Mang0-TEC/esp32-photo-frame/docs/BOM-marco-fotos-esp32.md

# BOM — Marco de Fotos Digital ESP32

**Proyecto:** Marco de fotos digital con servidor local WiFi
**Presupuesto objetivo:** $700 MXN
**Gastado:** $514 MXN · **Pendiente de comprar:** $0

---

## A. Comprar

**Nada. La tabla está vacía por primera vez en el proyecto.**

Lo último que quedaba era la reposición del sensor de luz, y **no se repuso: se
sustituyó**. El GY-302 (BH1750) que se estropeó en el banco el 7-ago-2026 se
cambió por un **módulo TSL2561 de Handson Technology**, SKU `SSR1026`, **$127** —
ya comprado y en mano. Con eso el gastado sube de $387 a **$514** y el pendiente
baja a cero, contra un presupuesto objetivo de $700.

**No es un reemplazo pin a pin, y por eso tiene sección propia más abajo.** El
módulo lleva regulador de 3.3 V a bordo, así que su alimentación cambia de riel;
`ADDR` deja de ser un cable y pasa a ser un puente soldable en la placa; aparece
un `INT` que no se usa; y el chip entrega **dos canales crudos** en vez de un
registro de lux ya calculado. El `0x23` medido del BH1750 no se transfiere.

**El ESP32 de reposición** estuvo en esta tabla porque la unidad USB-C que había
resultó defectuosa — no transmitía ni sincronizaba con esptool, ni en macOS ni en
Windows, pese a 3.3 V correctos, `EN` liberado y loopback TX0↔RX0 exitoso. Ese
diagnóstico sigue cerrado: la unidad nueva es **otra placa física**, con puente y
revisión de silicio distintos, no la misma que volvió a probarse.

**Debe ser WROOM, no WROVER.** La WROVER ocupa GPIO16 y GPIO17 con la PSRAM, y
ahí van `RST` y `DC` del display. **Confirmado WROOM en la unidad nueva**, medido
—no leído de la etiqueta— con `ESP.getPsramSize()` desde el banco del LED:
`PSRAM 0 B`. GPIO16 y GPIO17 quedan libres y el mapa de pines cierra. esptool no
reporta PSRAM, de ahí que la comprobación viva en el banco; sale gratis porque ese
flasheo se hace igual, y descubrirlo después de soldar cuesta la pantalla entera.

---

## B. Ya en inventario

| # | Componente | Nota |
|---|---|---|
| 5 | ESP32 DevKit WROOM, **micro-USB** | **Placa de desarrollo.** Puente CP2102, `/dev/cu.usbserial-0001`. Chip verificado `ESP32-D0WD-V3 rev v3.0`, cristal 40 MHz, flash 4 MB |
| 6 | Tarjeta SD 8 GB | FAT32, fotos en subdirectorio `/fotos/` |
| 7 | Cargador USB 5 V ≥1 A + cable USB-C | Alimentación permanente |
| 8 | Capacitor electrolítico 100 µF / 16 V | ✔ Confirmado |
| 9 | Capacitores cerámicos 100 nF (código "104") | ✔ Confirmado — 3 piezas, de las que **solo se usan 2**: display y lector SD. El tercero quedó libre al entrar el TSL2561, que trae cuatro condensadores propios y uno de ellos pegado al `VDD` del chip |
| 10 | Transistor PN2222A (NPN, TO-92) | **Sin uso.** Era para el backlight en Caso A; `BL` resultó entrada lógica y va directo a GPIO19. Se queda en inventario |
| 11 | LED RGB 5 mm **cátodo común** | ✔ Sustituye a los dos LEDs separados |
| 12 | Resistencias **220 Ω** (LED rojo), 470 Ω ×2 (LED verde y azul), 10 kΩ, más surtido | El rojo llevaba 1 kΩ y **se cambió a 220 Ω** tras verse más apagado que los otros dos; con eso el blanco sale blanco. El 1 kΩ queda libre. Las dos 470 Ω están puestas en el LED, y **no hace falta una tercera**: el backlight resultó Caso B y va directo a GPIO19, sin transistor y sin resistencia de base. Ver la nota de corriente por canal, abajo |
| 13 | Header macho 2.54 mm (9 pines) | ✔ Confirmado |
| 14 | Cable UTP Cat5e (núcleo sólido 24 AWG) | ✔ Sustituye jumpers Dupont |
| 15 | Filamento **PETG negro** | Carcasa frontal, tapa trasera y base, ~70 g el juego completo — detalle en [`carcasa/README.md`](../carcasa/README.md). **Confirmado 10-oct-2026**, y no es PLA: el PLA reblandece cerca de 60 °C, y esto vive encendido 24/7, quizá junto a una ventana, dentro de una carcasa sellada donde el AMS1117 ya calienta. El PETG aguanta y es menos frágil. **El grosor de pared en la zona del pad NO es libre**: lo fija la medición del touch — ver la sección de touch capacitivo |
| 17 | Módulo **TSL2561** (Handson Technology, SKU `SSR1026`) — $127 ya pagados | **Sustituye al GY-302/BH1750**, que se estropeó en el banco. `Vin` va al riel de **5 V**, no a 3.3: lleva LDO propio (`662K`). Cinco pines, de los que se usan cuatro — `INT` se deja al aire. Dirección I2C **`0x39`, medida en placa**. Sección propia más abajo |
| 16 | ESP32 DevKit **USB-C** — reposición, $126 ya pagados | **Candidata a unidad final.** Puente **CH340** (`0x1a86:0x7523`). **Los `.ini` ya no fijan el puerto**: se quitaron `upload_port` y `monitor_port` de los cinco envs para que PlatformIO autodetecte, porque el sufijo del tty es el location ID del USB y cambia al mover el cable de puerto. Detalle del mecanismo en `CLAUDE.md`. Verificado con esptool: `ESP32-D0WD-V3 rev v3.1`, cristal 40 MHz, flash 4 MB, MAC `70:4b:ca:48:d3:ec`. **WROOM confirmado** — `PSRAM 0 B` medido desde el banco del LED |

La placa micro-USB **no es la unidad final**: micro-USB es mal conector para un
objeto fijo 24/7 durante años; se afloja y su pad termina desprendiéndose del
PCB. Sirve para todo el desarrollo del firmware — el chip es el mismo
`ESP32-D0WD-V3` — y el cambio a la USB-C final no toca una sola línea de código.

---

## C. Verificar / conseguir

| # | Componente | Cant. | Para qué |
|---|---|---|---|
| ~~16~~ | ~~Pad conductor para touch capacitivo~~ | 1 | **Resuelto: cinta de cobre** (opción 2), cuadrado de ~12-15 mm con un hilo de UTP a GPIO32. Cableado, trampas y montaje en la sección de touch capacitivo |
| 17 | Termofit surtido | — | Aislar uniones soldadas |
| 18 | Soldadura + flux | — | Header y cableado |
| 19 | Silicón caliente | — | Alivio de tensión del UTP |
| 20 | Tornillos M3×8 (Allen o avellanado) | 2 | Cierre de la carcasa. **Sin insertos termofijos** (no hay en inventario): roscan directo en dos postes de PETG, y la tapa además engancha un labio arriba. El diámetro del agujero se fija con la probeta de ajustes (2.5–2.8 mm) |

---

## D. Descartado (y por qué)

| Componente | Razón |
|---|---|
| ESP32-S3 DevKit | TJpg_Decoder trabaja por bloques MCU 16×16; no necesita framebuffer completo. El clásico basta |
| ESP32 **WROVER** | Ocupa GPIO16 y GPIO17 con la PSRAM, y ahí van `RST` y `DC` del display |
| Módulo USB standalone | El pin `5V`/`VIN` del devkit ya entrega VBUS |
| Step-down LM2596S | Solo haría falta alimentando desde 12 V |
| Batería LiPo | ~250 mA continuos → ~8 h. LCD necesita alimentación constante. Riesgo de hinchamiento en carcasa sellada |
| PIR HC-SR501 | Domo de 23 mm imposible de ocultar |
| Sensor ultrasónico HC-SR04 | Peor estética; cono de 15° detecta paredes, no personas |
| Sensor IR proximidad | Alcance de centímetros, no de habitación |
| Botón físico | Reemplazado por touch capacitivo del ESP32 (0 componentes) |
| Dos LEDs separados (verde + ámbar) | Reemplazados por el RGB: un solo barreno, más estados distinguibles |
| Jumpers Dupont | UTP soldado ocupa menos espacio interno |
| Google Drive como backend | OAuth2 se rompe solo con el tiempo; ata el regalo a una cuenta ajena |
| Switch de orientación / acelerómetro | Se decidió orientación nativa con barras. Reevaluar tras pruebas |
| Filamento PLA | Sustituido por PETG: el marco es un objeto cerrado y prendido 24/7, y el PLA se ablanda a temperatura más baja |
| Insertos roscados termofijos M3 | No hay en inventario. Los M3 roscan directo en postes de PETG, y solo hacen falta 2 |
| Pata trasera para sobremesa | Recargado hacia atrás, el marco se apoya en su canto trasero, y con el display al frente el centro de masa queda delante: vuelca a 15°. Se usa una base cuna |

---

## Mapa de GPIOs

| Función | Pin del módulo | GPIO |
|---|---|---|
| **Display — VSPI** | | |
| Reloj | `SCL` | 18 |
| Datos | `SDA` | 23 |
| Chip select | `CS` | 5 |
| Data/Command | `DC` | 17 |
| Reset | `RST` | 16 |
| Backlight (PWM) | `BL` | 19 |
| Salida de datos | `SDA-0` | **NC** |
| Alimentación | `VIN` / `GND` | **5 V** / GND |
| **Lector SD — HSPI** | | |
| Reloj | `SCK` | 14 |
| Datos hacia SD | `MOSI` | 13 |
| Datos desde SD | `MISO` | 27 |
| Chip select | `CS` | 26 |
| Alimentación | `+5` / `GND` | **5 V** / GND |
| **TSL2561 — I2C** (en orden físico del header) | | |
| Alimentación | `Vin` — pad cuadrado, pin 1 | **5 V** |
| Tierra | `GND` — pin 2 | GND |
| Reloj | `SCL` — pin 3 | 22 |
| Datos | `SDA` — pin 4 | 21 |
| Interrupción | `INT` — pin 5 | **NC** |
| **LED RGB (cátodo común)** | | |
| Azul (470 Ω) | pin 1 | 4 |
| Verde (470 Ω) | pin 2 | 33 |
| Común | pin 3 | GND |
| Rojo (220 Ω) | pin 4 | 25 |
| **Touch capacitivo** | | |
| Pad (T9) | — | 32 |

### Justificación de la asignación

- **GPIO12 evitado deliberadamente**, aunque es el MISO nativo del HSPI. Es pin de strapping: alto al arrancar configura la flash a 1.8 V y la placa no bootea. Como el H95 no trae buffer, MISO no queda en alta impedancia confiable → lotería en cada encendido. MISO va a GPIO27.
- **GPIO19 para backlight** aprovecha el pin liberado al no conectar `SDA-0`. Soporta PWM por LEDC.
- **GPIO0, 2 y 15 evitados** (strapping). **GPIO34-39 evitados** (solo entrada).
- **GPIO5 sí es strapping** pero necesita estar alto al arrancar — justo el estado de reposo de un CS.
- **Nota:** GPIOs 4, 13, 14, 25, 26, 27 son ADC2, que no funciona con WiFi activo. Aquí todos son digitales, sin problema. Tenerlo presente si se agrega un sensor analógico.

---

## Notas críticas de armado

### Alimentación

- **Display (`VIN`) y lector SD (`+5`) van al riel de 5 V**, no a 3.3 V. Ambos traen regulación propia. Así el AMS1117 del devkit no disipa el consumo del backlight (~0.7 W) dentro de una carcasa sellada sin ventilación.
- **En el lector SD, deja el pin `3.3V` sin conectar.** Solo se usa `+5`.
- **El TSL2561 va a 5 V, y esto CAMBIÓ respecto del BH1750.** El GY-302 iba a 3.3 V porque no llevaba regulador: el chip se alimentaba directo, y darle 5 V habría subido las líneas I2C por encima del nivel lógico del ESP32. Este módulo sí lo lleva —un `662K`, LDO de 3.3 V— así que entra en la misma regla que el display y el lector SD. **Las líneas I2C siguen a 3.3 V** porque las pull-ups cuelgan del riel *post-LDO*; en la sección del sensor está la medida que hay que hacer antes de conectarlo.
- **El capacitor de 100 µF no es opcional.** Entre 5 V y GND, lo más cerca posible del lector SD. Sin él, los picos de escritura hunden el riel y resetean el ESP32 — falla intermitente y difícil de diagnosticar con la carcasa cerrada.
- Un capacitor de 100 nF en VCC-GND de cada módulo: **display y lector SD**. Son dos de los tres cerámicos «104» de la tabla B; **el tercero quedó libre** al entrar el TSL2561, que trae los suyos.

> **El lector SD lleva LOS DOS, y no son redundantes** — es la duda que surge al leer las dos líneas de arriba seguidas. Cubren bandas de frecuencia distintas: el **electrolítico de 100 µF** es reserva de carga para las ráfagas de escritura (decenas de mA durante decenas de ms) y su ESR y ESL lo incapacitan para responder a un flanco de nanosegundos; el **cerámico de 100 nF** es desacoplo de alta frecuencia para los flancos del SPI y la lógica de la tarjeta, y no almacena nada útil a escala de milisegundos. Con solo el electrolítico el riel queda sucio en alta frecuencia; con solo el cerámico se hunde en cada escritura.
>
> **El cerámico va más cerca que el electrolítico**, lo más pegado posible a los pines `+5` y `GND` del módulo: el lazo corto es lo que lo hace funcionar. El electrolítico puede quedar un poco más atrás.
>
> **Y al sensor no le va NINGUNO de los dos, que es el caso opuesto y conviene leerlo aquí mismo.** El argumento de arriba es de corriente, y el TSL2561 consume **0.6 mA máximo y constante**: no hay ráfaga que amortiguar. Además el módulo ya trae cuatro condensadores propios —1 µF a la entrada del LDO, 10 µF y 0.1 µF a su salida, y **0.1 µF pegado al `VDD` del chip**—, así que el 100 nF que se iba a añadir habría quedado en paralelo con uno de 1 µF, diez veces mayor, y con un regulador de por medio. El trabajo de atender flancos junto al chip ya lo hace el suyo, que está más cerca de lo que jamás podría estar uno en el header.
>
> Eso salía del esquemático del módulo, que **ya falló en dos puntos verificables** contra la foto de su propia placa (dice 4.7 kΩ donde la foto muestra «103», y dibuja un puente de dos estados donde hay tres pads), así que quedó pendiente contar los condensadores de vista. **Se cierra el 8-ago-2026 por vía funcional, que es más fuerte que contarlos:** el módulo lee estable —1 % de dispersión en 10 muestras, y el mismo valor a lo largo de decenas de tandas— y **no produjo un solo error de I2C** salvo cuando se le desconectó el cable a propósito. Un desacoplo ausente se habría visto justo ahí. Si algún módulo de recambio diera lecturas ruidosas o errores de bus, el primer sospechoso es ése, y la salida es un 100 nF entre `Vin` y `GND` pegado al header.

### Backlight — determinar el tipo de pin `BL` antes de soldar

El pin `BL` equivale al `LED`/`BLK`/`LED-A` de otros módulos.

> **Corrección al procedimiento anterior, que era ambiguo.** La versión previa de
> esta tabla decía «solo uno funciona → respuesta inequívoca». **No es cierto:**
> dos desenlaces distintos mandan `BL` a alto y se ven idénticos en una prueba de
> sí/no, pero son circuitos muy diferentes —una entrada lógica pasa µA y un ánodo
> crudo pasa decenas de mA—. El discriminante es la **corriente**, no el
> encendido, y por eso el paso 3 lleva ahora una medición. Es la misma técnica que
> quedó escrita para el LED RGB: voltímetro sobre la resistencia e `I = V/R`.

#### Paso 0 — la lectura al aire, que es la que más dice y no cuesta nada

Solo `VIN` a 5 V y `GND`. `BL` **al aire**. Multímetro en DC volts de `BL` a GND: sus 10 MΩ de entrada pasan ~0.5 µA, así que no enciende ni daña nada.

| Lectura en `BL` al aire | Qué significa | Caso |
|---|---|---|
| ≈5 V (o ≈3.3 V) **y el backlight encendido** | entrada lógica con pull-up | **B** |
| ≈0 V, backlight apagado | entrada lógica con pull-down, o base flotante | **B** — confirmar en el paso 3 |
| **intermedia, ~1.5–3 V**, backlight apagado | hay un LED en serie hacia el riel: el nodo se queda un Vf por debajo | **A — cátodo crudo** |

La lectura intermedia es la firma de un diodo en el camino, y va antes de conectar ningún cable.

#### El paso decisivo: `BL` a un riel a través de 100 Ω, y medir la caída **sobre la resistencia**

Los 100 Ω hacen doble trabajo: limitan la corriente y sirven de shunt. `I = V/R`, la misma técnica que quedó escrita para el LED RGB. El entregable es la corriente, no el «prende sí o no».

### Resultado — pendiente #1 CERRADO, Caso B: `BL` es entrada lógica

**Medido en placa sobre el AR3952, con 100 Ω en serie:**

| Riel | V sobre los 100 Ω | Corriente | Tensión en `BL` |
|---|---|---|---|
| 5.0 V | 0.140 V | **1.40 mA** | 4.86 V |
| 3.3 V | 0.088 V | **0.88 mA** | 3.21 V |

Prende en los dos, y con un potenciómetro en serie la atenuación se distingue a simple vista.

**Por qué es inequívoco.** 1.40 mA no encienden un panel de 3.5". Si `BL` fuera el ánodo del string, la corriente del backlight —decenas de mA— pasaría por ese pin y el nodo quedaría clavado cerca del Vf, no a 0.14 V del riel. Que el panel encienda brillante mientras el pin pasa 1.4 mA significa que **la corriente del backlight sale de `VIN` por un driver del propio módulo**, y eso es la definición de una entrada de control.

**Y el Caso A queda descartado por la misma observación:** un cátodo crudo no puede encender con 5 V aplicados al pin — los LEDs quedarían sin tensión o en inversa.

**Las dos lecturas ajustan una recta y dan la impedancia de entrada:** ΔV/ΔI = (4.86 − 3.21) V / (1.40 − 0.88) mA = **3.17 kΩ**. Es un valor de catálogo para una resistencia de base, y explica la atenuación con el potenciómetro: control por corriente de base en zona activa. El ajuste deja un offset de ~0.42 V, más bajo que el Vbe de un BJT de silicio; con dos puntos de un multímetro de mano eso está en el ruido y **no se afirma si hay o no una unión ahí dentro**. Da igual para la decisión.

> **La tabla de umbrales que traía este documento se quedó corta y conviene decirlo.** Proponía «< 1 mA → entrada lógica» y «> 10 mA → ánodo», y el valor real, 1.4 mA, cayó en el hueco. El hueco no genera ambigüedad porque la pregunta de fondo es de orden de magnitud —¿es ésta la corriente del backlight o no?— y 1.4 mA está unas 70 veces por debajo de lo que consume el panel. El criterio correcto es ése, no un umbral numérico.

**Consecuencias:**

- **`BL` va directo a GPIO19**, PWM por LEDC en sentido intuitivo (`ledcWrite(pin, 0-255)`, alto = brillante). **Sin transistor, sin resistencia de base, sin el 10 kΩ.**
- **El pendiente #2 desaparece**, y con él el PN2222A del circuito del backlight. Ver abajo.
- El backlight se alimenta de `VIN` (5 V) a través del driver del módulo, que es lo que este BOM ya especificaba para el riel de 5 V.

**Confirmado también de vista, desde `[env:display]` con GPIO19 haciendo el PWM:** la atenuación se ve **gradual y sin parpadeo** a lo largo de toda la escalera, y en duty 0 el backlight queda **completamente apagado**. O sea que el driver del módulo satura con los 0.88 mA que da un GPIO a 3.3 V, que era lo único que el voltímetro no podía contestar. `ledcAttach(19, 5000, 8)` y `ledcWrite` en sentido intuitivo, sin invertir.

> La escalera del banco se recorre de 20 en 20 y a ese paso el salto **se siente brusco**. No es representativo: la rampa de producción avanza **un paso de PWM por lectura del sensor de luz** (§7), no veinte.

**Y el arranque en frío con `BL` al aire no da destello — OBSERVADO, 8-ago-2026.** Con `BL` desconectado el backlight queda en brillo 0. Deja de ser inferencia: la versión anterior de este párrafo lo deducía de que al aplicar 3.3 V la corriente **entra** al pin (con un pull-up hacia VCC saldría, así que `BL` la drena hacia una base o un pull-down y con GPIO19 flotando no hay excitación). El razonamiento era correcto y ahora está confirmado de vista, que es lo que `display.cpp` asume al poner el brillo a 0 antes de `tft.begin()`.

**Notas del procedimiento**, por si hay que repetirlo con otro módulo: en cuarto oscuro y mirando el **canto** del módulo, no el frente — con el ST7796S sin inicializar el panel puede quedar opaco y el backlight solo se ve como fuga de luz en los bordes. El riel del paso 3 sale del pin del propio devkit, con el devkit alimentado, para compartir referencia de tierra. Ninguno de los pasos daña nada.

### PN2222A — fuera del backlight, pendiente #2 cerrado por irrelevancia

**El transistor no va.** `BL` resultó entrada lógica (arriba), así que no hay nada que conmutar: GPIO19 maneja el driver del módulo directamente. Con eso caen también sus 470 Ω de base y el 10 kΩ de base a emisor, y **la tercera resistencia de 470 Ω que este documento reservaba para el Caso A ya no hace falta**.

El PN2222A se queda en inventario sin uso asignado. Su pendiente de pinout —pin central = base confirmado, pero 0.704 V contra 0.703 V hacia los extremos, dentro del ruido del instrumento— **deja de importar**: se resolvería con zócalo hFE (orientación correcta → beta 100-300, invertida → beta 2-5) el día que se le encuentre otro trabajo. No es una deuda de este proyecto.

### LED RGB — cátodo común (confirmado con multímetro)

Pinout medido de izquierda a derecha: **azul, verde, GND, rojo**. El común en tercera posición no es el orden más habitual — por eso valió medirlo.

Resistencias **en serie con cada color, nunca en la pata común**. Una sola resistencia común haría que el brillo cambie según cuántos colores estén activos (el blanco saldría más tenue que el rojo). Además los voltajes directos difieren: rojo ~2.0 V, verde y azul ~3.0 V.

**Valores finales: 220 Ω en rojo, 470 Ω en verde y azul.** El rojo empezó con 1 kΩ y hubo que bajarlo; el porqué está tres párrafos más abajo y no es el que dice el cálculo.

Con cátodo común el PWM funciona en sentido intuitivo: `ledcWrite(canal, 0-255)` directo, sin invertir. El ESP32 tiene 16 canales LEDC; se asignan tres.

#### El rojo lleva 220 Ω, no 1 kΩ — y la razón contradice el cálculo

**Resuelto en placa, y el resultado fue el contrario del previsto.** El cálculo
sobre el papel decía esto, con los Vf de ficha —**asumidos, nunca medidos**— y un
GPIO en 3.3 V:

| Canal | R original | Vf asumido | Corriente calculada |
|---|---|---|---|
| Rojo | 1 kΩ | ~2.0 V | 1.3 mA |
| Verde | 470 Ω | ~3.0 V | 0.64 mA |
| Azul | 470 Ω | ~3.0 V | 0.64 mA |

De ahí se predijo que el rojo dominaría y **que el blanco saldría rosa**. Es
falso: encendiendo un canal a la vez desde el banco, **el rojo se ve claramente
más apagado** que el verde y el azul, que salen intensos.

**Por qué el cálculo no bastaba: mide corriente, y lo que importa es brillo
percibido.** Dos factores que no aparecen en la ley de Ohm y que van en la misma
dirección:

- La curva fotópica del ojo vale ~1.0 a 555 nm (verde) y cae a ~0.27 a 630 nm
  (rojo). A igual potencia radiada el verde se ve unas cuatro veces más.
- Verde y azul son InGaN, bastante más eficientes por mA que el rojo AlGaInP, y
  lo siguen siendo a corrientes bajas.

Entre los dos, el doble de corriente en el rojo no compensa ni de lejos.

**La corrección va en el rojo y es de hardware: 1 kΩ → 220 Ω**, que con el Vf
asumido lo sube de 1.3 mA a ~5.9 mA. Con eso el blanco `(255,255,255)` **se ve
blanco**, verificado a ojo. Se prefirió el hierro al software porque bajar verde y
azul con `LedRGB::escala` habría igualado los canales tirando brillo, y el
conjunto ya es tenue a propósito. `escala` se queda en identidad y sigue ahí como
perilla para el ajuste fino que haga falta tras montar la carcasa.

**El riesgo caro queda descartado:** verde y azul encienden bien e intensos, así
que la hipótesis de que 0.3 V de margen sobre el Vf los dejara inservibles era
infundada. Sus 470 Ω se quedan.

**El ámbar hubo que recalibrarlo, y su valor depende de estas resistencias.** El
`(255, 80, 0)` de la tabla de estados se eligió en el escritorio suponiendo
canales equilibrados, y sobre el hardware real tiraba a verde — el peor fallo
posible en esa fila, porque ámbar es «subiendo» y rojo es «falló» y tienen que
distinguirse de un vistazo. Barrido con la tecla `c` del banco, el valor bueno es
**`(255, 70, 0)`**. Vale para 220 Ω en el rojo y 470 Ω en el verde: **si esas
resistencias cambian, hay que volver a barrerlo.**

> **Las corrientes por canal no se van a medir, y se cierra a propósito.** Todo lo
> de arriba se decidió por observación visual del compuesto, que **es el criterio
> correcto**: lo que importa es el brillo percibido, y el cálculo de corriente ya
> demostró que predice el desequilibrio al revés. Con el rojo en 220 Ω el blanco
> sale blanco y los tres canales se ven parejos, así que el número no tiene
> consumidor — medirlo daría un dato exacto sobre una decisión ya tomada por el
> criterio bueno. Se retira de pendientes el 8-ago-2026.
>
> Si alguna vez hiciera falta —otro LED, otras resistencias— la técnica está
> escrita: **voltímetro en paralelo sobre cada resistencia e `I = V/R`, nunca
> amperímetro en serie**, porque verde y azul tienen ~0.3 V de margen sobre su Vf
> y el shunt saldría de ahí.

### Conexiones del display (8 cables)

`GND`, `VIN`, `SCL`, `SDA`, `RST`, `DC`, `CS`, `BL`

**`SDA-0` (SDO/MISO) se deja SIN CONECTAR.** El flujo es unidireccional: se lee el JPEG de la SD y se empujan píxeles al display, nunca se le pregunta nada. Además la lectura por SPI en estos módulos es poco confiable (devuelve 18 bits aunque escribas 16) y muchas placas genéricas no liberan bien MISO en alta impedancia.

### Dos buses SPI separados — obligatorio

- **VSPI** → Display
- **HSPI** → Lector SD

El H95 **no trae buffer 74LVC125** (sus R1-R4 marcados "101" son solo 100 Ω de protección en serie, no level shifting). Sin buffer, MISO no se libera limpiamente cuando CS está en alto. Compartir un solo bus daría corrupción de imagen intermitente.

**Confirmación externa:** [TFT_eSPI issue #3601](https://github.com/Bodmer/TFT_eSPI/issues/3601). El ejemplo oficial `ESP32_SDcard_jpeg` falla cuando TFT_eSPI y la librería `SD` terminan en buses distintos sin declararlo explícitamente. La solución del reportante es exactamente la arquitectura de aquí: instanciar `SPIClass hspi(HSPI)` con pines dedicados y pasarlo a `SD.begin(CS, hspi)`. Cita textual del hilo: le tomó dos días encontrarlo. Vale tenerlo referenciado para no reabrir la decisión más adelante.

```cpp
montarTarjeta(14 /*SCK*/, 27 /*MISO*/, 13 /*MOSI*/, 26 /*CS*/, 20000000);  // src/tarjeta.h
tft.begin();   // VSPI, por defecto
```

> El montaje ya **no** es `SPIClass hspi(HSPI)` + `SD.begin(26, hspi)` como decía
> este bloque antes: la librería `SD` de Arduino no monta las tarjetas de este
> proyecto y se sustituyó por el driver sdspi del IDF. El porqué, medido, está
> más abajo en «La librería `SD` de Arduino no se usa». El reparto de buses no
> cambia: SPI2 (HSPI) para la tarjeta, SPI3 (VSPI) para el display.

#### Coexistencia verificada en placa, 2026-08-07 — el #3601 NO se manifiesta

189 segundos sostenidos, con una tarea de FreeRTOS anclada al **core 0**
escribiendo, releyendo y comparando 32 KB contra la tarjeta mientras `loop()`
pintaba en el **core 1**. Concurrente y no alternado a propósito: es lo que hace
producción, porque la escritura ocurre en el callback de `/upload` (hilo
`async_tcp`, prioridad 10) mientras `loop()` puede estar empujando píxeles.

| | Corrida 1 | Corrida 2 |
|---|---|---|
| Duración | 189.2 s | 185.9 s |
| Ciclos de SD | 401 escribir+releer+comparar de 32 KB | 394 |
| **Discrepancias** | **0** — cero fallos de escritura y de lectura | **0** |
| Pasadas de display | 1,277 | 1,253 |
| Rayas de 1 px, media / máx | 68.6 / 70 ms — línea base **67** | 68.6 / 70 |
| Bloques 16×16, media / máx | 79.2 / 84 ms — línea base **77** | 79.2 / 84 |

**Son dos corridas y no una, y las medias salen idénticas al decimal.** Entre
ambas, **795 ciclos y ~52 MB verificados byte a byte sin una sola discrepancia**.
La degradación del display es de +2.4 % en las rayas y +2.9 % en los bloques.

**El veredicto es asimétrico y conviene saberlo al leerlo:** el lado de la SD se
autoverifica byte a byte con la relectura, pero el display **no se puede leer de
vuelta** (`TFT_MISO=-1`, `SDA-0` sin conectar), así que el suyo es visual.
Comprobado de vista durante la corrida: **sin bandas, sin píxeles corridos y sin
rayas que cambien de fase**.

> Se ve **el barrido** de las líneas avanzando por la pantalla, y eso NO es un
> síntoma: `drawFastVLine` pinta las 320 columnas de una en una y la pasada dura
> 68 ms, así que el dibujado es visible. Anotado porque es justo lo que alguien
> va a reportar como «se ve raro».

**El coste de la contención lo paga la SD, no el display.** Su escritura media
sube de 67 ms a **435 ms** durante la prueba, mientras el display pierde un 3 %.
Tiene sentido: `loop()` acapara CPU y la tarea de la tarjeta cede en cada vuelta.
Para el marco es el reparto correcto — lo que no puede tartamudear es la imagen.

### Touch capacitivo

El ESP32 tiene 10 pines de touch nativo (T0-T9). Un pad conductor pegado **por dentro** de la pared de la carcasa funciona a través de 1.5-2 mm de **PETG**. Sin sensor visible, sin botón, $0 de costo.

> **En la carcasa v3 el pad va en el canto superior**, en una bolsa de 25 × 18 × 0.5 mm que deja 1.5 mm de PETG negro entre el pad y el dedo. Dos cosas de esta misma sección la corrigen, y se aplican en la v4: el grosor de 1.5 mm es **provisional** hasta llenar la tabla de la tecla `t`, y la bolsa quedó a ~2 mm del borde superior del PCB del display y casi encima de su header — masa justo detrás del pad, que es la trampa 2 de abajo.
>
> **Desde la carcasa v5 el pad va en la pared derecha, abajo** (lado del lector SD, vista frontal), en una bolsa de 15 × 15 × 0.5 mm con la misma pared de 1.5 mm. El canto superior quedó para el TSL2561, la tira de pines del display y el gancho de la tapa. El pad queda a más de 10 mm de todo PCB, pero el hilo a GPIO32 crece a unos 7–10 cm, en el límite del rango de arriba.

Opciones de pad, en orden de preferencia:

1. **Placa fenólica / perfboard** — se suelda el cable directo al cobre. Ideal.
2. **Cinta de cobre** — se suelda bien.
3. **Alambre sólido enrollado en espiral plana** — funciona y ya está en inventario.
4. **Papel aluminio de cocina** — funciona eléctricamente pero **no se puede soldar** (el óxido de aluminio lo impide). Requiere sujeción mecánica: prensado bajo cinta o con tornillo. Punto de falla dentro de carcasa cerrada.
5. **Moneda de $1** con cable sujeto con cinta.

#### Elegida la opción 2, cinta de cobre — cableado y montaje

Cuadrado de **~12-15 mm de lado**: más pequeño no da delta, y más grande sube la
capacitancia base y baja el delta **relativo**, que es lo que se mide.

```text
   cinta de cobre  ~12×12 mm
   ┌──────────────┐
   │              │        UTP, UN hilo, 5-10 cm
   │      ▓ ←─────┼────────────────/\/\/\──────────  GPIO32  (T9)
   │   soldadura  │              1 kΩ, junto al ESP32
   └──────────────┘
     cara pegada a la pared,
     NADA de cobre ni masa detrás
```

**Sin GND, sin pull-up y sin capacitor.** El sensor mide el tiempo de carga del
propio pad: todo lo que añada capacitancia fija sube la línea base y **encoge el
delta**, que es la señal.

**Tres trampas, y la primera contradice a este mismo documento a propósito:**

1. **NO trenzar el hilo del touch con un retorno de tierra.** El cableado con UTP
   de más abajo lo recomienda para las líneas SPI —reduce diafonía— y aquí es
   exactamente lo contrario: un par trenzado son ~50-100 pF/m en paralelo con el
   pad. **Misma bobina de cable, regla opuesta.** Y hay que rutearlo lejos de
   GPIO19, que conmuta ~100 mA a 5 kHz.
2. **Nada de masa detrás del pad** — ni plano de tierra, ni el PCB del display
   (94.8 × 59.19 mm con sus masas), ni el devkit. El instinto de blindar una
   señal sensible mata el sensor.
3. **El delta depende de si el cargador tiene tierra.** El touch funciona porque
   el cuerpo está acoplado a tierra, y una fuente USB de dos pines acopla peor
   que el USB de la Mac. Hay que medir con las dos. Mismo tipo de confusor que
   «el cableado con el que se midió» del pendiente #3.

**La resistencia de 1 kΩ es ESD, y en el marco terminado no hace falta.** Limita
el pico que un dedo cargado mete al pin: con el modelo de cuerpo humano (1.5 kΩ
propios) y 4 kV, pasa de 2.7 A a 1.6 A. Pero **en el marco el dedo nunca toca
cobre, toca PETG**, cuya rigidez dieléctrica (~15-20 kV/mm) hace que 1.5 mm
aguanten 20+ kV: la pared ya es mejor protección de lo que puede ser una
resistencia en serie. Gana su sitio **durante la medición**, con el cobre desnudo
en protoboard. Se deja puesta para que el número del banco y el del marco salgan
del mismo circuito; su coste es un RC de ~20 ns contra un periodo de medición de
microsegundos. Valor no crítico (470 Ω - 2 kΩ), y **el 1 kΩ ya está libre en
inventario**: es el que salió del LED rojo al bajarlo a 220 Ω.

**Al soldar la cinta:** es de ~0.05 mm y el soldador la agujerea. Doblar una
esquina sobre sí misma para tener doble espesor y soldar ahí, punta a 300-320 °C,
hilo ya estañado, un punto y fuera — el adhesivo humea si te entretienes. Y
**silicón caliente encima**, que es el alivio de tensión que este documento ya
exige para todas las uniones: la cinta se despega de un tirón.

> **En protoboard el número sale pesimista** —cable largo, tiras metálicas—, o
> sea que lo que funcione ahí funciona mejor soldado. Dirección segura, al revés
> del barrido de SPI del pendiente #3.

#### El umbral y el grosor de pared — tecla `t` de `[env:display]`

<!-- PENDIENTE DE MEDICIÓN. Al correr la tecla `t` se rellenan las dos filas y se
     fija TOQUE_DELTA en firmware/src/toque.h, hoy provisional en 15. -->

| Condición | Ruido σ | Delta pico |
|---|---|---|
| Dedo directo sobre el cobre | | |
| A través de 1.5 mm de PETG | | |
| A través de 2.0 mm de PETG | | |
| A través de 2.5 mm de PETG | | |
| Dedo cerca, sin tocar | | |

`TOQUE_DELTA` se fija con un criterio doble: la **mitad** del delta pico más
pequeño a través del cupón más grueso que vaya a llevar la carcasa, y que ese
valor quede **por encima de 5 σ** del ruido de reposo. Si no cumple las dos, la
pared es demasiado gruesa — y eso es un dato de diseño mecánico, no un fallo del
firmware.

> **Los cupones se imprimen con los mismos perímetros y el mismo relleno que la
> pared real.** Sólidos contra una carcasa al 20 % es otro dieléctrico y el
> número no transfiere.

### Cableado con UTP

- Cat5e núcleo sólido 24 AWG: sobrado para ~300 mA, suelda limpio, ocupa menos que Dupont.
- Ocho colores para codificación.
- Su debilidad (se fractura al flexionarse) es irrelevante en montaje fijo.
- **Alivio de tensión con un punto de silicón caliente cerca de cada soldadura.**
- Bonus gratis: son pares trenzados. Trenzar cada línea SPI con un retorno de tierra reduce diafonía. Probablemente imperceptible a estas frecuencias y distancias, pero no cuesta nada.

---

## Toolchain: PlatformIO

**Decisión cerrada:** PlatformIO con `framework = arduino`, **no** ESP-IDF puro.

Razón: las seis librerías del stack (`TFT_eSPI`, `TJpg_Decoder`, `WiFiManager`, `QRCode`, `ESPAsyncWebServer`, `AsyncTCP`) son del ecosistema Arduino. ESP-IDF puro obligaría a reemplazarlas por `esp_lcd` + `esp_jpeg` + provisioning propio — más limpio a largo plazo pero implica reescribir el equivalente de WiFiManager, que es justo la pieza que sostiene la regla 1.

PlatformIO además fija versiones exactas en un archivo versionado, que es lo que hace el build reproducible dentro de tres años.

### Plataforma: pioarduino, no la oficial

La plataforma oficial `platformio/platform-espressif32` quedó estancada en arduino-esp32 2.x — su issue #1225 ("Support Arduino ESP32 v3.0") sigue abierto desde noviembre de 2023. El fork comunitario **pioarduino** es el que da arduino-esp32 3.x, y está activo (commits de julio 2026, actualmente Arduino 3.3.11 / IDF 5.5.5).

Ambas rutas son válidas para el ESP32 clásico. Se elige pioarduino por estar mantenida; la oficial 6.x era el plan B por si WiFiManager resultaba incompatible, y **ese plan B ya no hace falta**: el pendiente #5 se cerró el 6-ago-2026 con el provisioning verificado en placa sobre pioarduino `55.03.311`.

### `platformio.ini`

Los flags de TFT_eSPI **no viven aquí dentro**: viven en `firmware/tft_comun.ini`, sección `[tft]`, y entran por `extra_configs`. La razón está tres subsecciones más abajo, con el banco del display; el resumen es que un pin divergente haría que el banco probara otro circuito en silencio.

```ini
[platformio]
extra_configs = tft_comun.ini   ; los flags de TFT_eSPI, compartidos con el banco

[env:marco]
; Pinear a un tag de release concreto, no a "stable" — la etiqueta se mueve
platform = https://github.com/pioarduino/platform-espressif32/releases/download/55.03.311/platform-espressif32.zip
board     = esp32dev
framework = arduino

monitor_speed = 115200
board_build.partitions = huge_app.csv   ; sin OTA, todo el flash para la app

lib_deps =
    bodmer/TFT_eSPI@2.5.43
    bodmer/TJpg_Decoder@1.1.0
    tzapu/WiFiManager@2.0.17
    ricmoo/QRCode@0.0.1
    ESP32Async/ESPAsyncWebServer@3.12.0
    ESP32Async/AsyncTCP@3.5.0

build_flags =
    ; --- TFT_eSPI: config por flags, NUNCA editando User_Setup.h ---
    ; Driver, geometría, pines y fuentes vienen de tft_comun.ini. Si ese archivo
    ; falta, esta línea no resuelve y el build se cae con «No section: 'tft'» —
    ; verificado. No hay forma de compilar en silencio con otros pines.
    ${tft.build_flags}
    ; Las frecuencias NO se comparten: SPI_FREQUENCY es la variable del pendiente
    ; #3 y el barrido de tres binarios del banco no debe tocar la del marco.
    -D SPI_FREQUENCY=27000000       ; arrancar aquí, subir después
    -D SPI_READ_FREQUENCY=20000000  ; sin esta línea TFT_eSPI cae a 10 MHz, no
                                    ; a SPI_FREQUENCY (TFT_eSPI.h:126)
```

Y `firmware/tft_comun.ini`, que es lo que resuelve ese `${tft.build_flags}`:

```ini
[tft]
build_flags =
    -D USER_SETUP_LOADED=1
    -D ST7796_DRIVER=1
    -D TFT_WIDTH=320
    -D TFT_HEIGHT=480
    -D TFT_MISO=-1          ; SDA-0 sin conectar
    -D TFT_MOSI=23
    -D TFT_SCLK=18
    -D TFT_CS=5
    -D TFT_DC=17
    -D TFT_RST=16
    ; BL se controla aparte con LEDC — no declararlo aquí
    -D LOAD_GLCD=1
    -D LOAD_FONT2=1
    -D LOAD_FONT4=1
    -D LOAD_GFXFF=1
    -D SMOOTH_FONT=1
    ; USE_HSPI_PORT deliberadamente ausente
```

**La extracción se verificó contra el binario, no solo compilando:** RAM 55,988 B y Flash 1,232,897 B, idénticos al byte antes y después. Si algún flag se hubiera perdido en el camino, el tamaño habría cambiado.

**`TFT_WIDTH=320` y `TFT_HEIGHT=480` son las dimensiones físicas del panel y no dependen de cómo se monte el marco.** No se tocan al cambiar la orientación. Lo que fija la orientación es `tft.setRotation(0)` en el firmware, y ese es justamente el valor nativo del ST7796S: montado vertical, el driver no aplica ninguna transformación de coordenadas. Ver §6 de la especificación funcional.

**`USER_SETUP_LOADED=1` es la clave.** Le dice a TFT_eSPI que no lea `User_Setup.h`. Sin eso, la configuración vive dentro de la carpeta de la librería y se pierde en cada actualización o al clonar el repo en otra máquina — el dolor clásico de esta librería.

**`USE_HSPI_PORT` no debe definirse.** TFT_eSPI usa VSPI por defecto, que es lo que se quiere; el HSPI se asigna a la SD manualmente.

### Notas sobre las dependencias

| Librería | Nota |
|---|---|
| `ESP32Async/ESPAsyncWebServer` | **No usar `me-no-dev/ESPAsyncWebServer`: archivado el 20-ene-2025, solo lectura.** El fork ESP32Async incluye los fixes de concurrencia de `yubox-node-org`, que es precisamente donde vivían los bugs de upload multipart. Va en 3.x; anuncian una 4.x que dropea ESP8266 e IDF 4.x → **fijar la versión** |
| `ESP32Async/AsyncTCP` | Dependencia obligatoria del anterior. Debe venir del mismo fork, no mezclar con la de me-no-dev. **Su hilo `async_tcp` corre a prioridad 10 con 16384 B de stack** (`CONFIG_ASYNC_TCP_STACK_SIZE`, `8192*2`) — ver la trampa de abajo |
| `tzapu/WiFiManager` | **Riesgo cerrado 6-ago-2026**: el panic del issue #1797 no ocurre, provisioning verificado de extremo a extremo. Dos cosas que sí salieron de ahí: `getWiFiIsSaved()` miente si se llama antes de `WiFi.mode(WIFI_STA)`, y el portal se tradujo al español con `WM_STRINGS_FILE` porque el `wm_strings_es.h` de la librería está sin traducir — pendiente #5 |
| `bodmer/TJpg_Decoder` | **No confundir con `JPEGDecoder`**, el anterior del mismo autor. El ejemplo oficial `ESP32_SDcard_jpeg` usa el viejo; la API es distinta. Tres cosas que cuestan encontrar y ya están medidas: su `User_Config.h` define `TJPGD_LOAD_SD_LIBRARY` y **arrastra `<SD.h>` con su objeto global `SD`** —que aquí no se usa jamás, pero compilaría sin quejarse—; `setJpgScale()` toma el **divisor** (1/2/4/8) y un valor que no sea ésos cae a 1 **en silencio**; y el callback **no debe devolver `false`** para recortar por abajo, porque `jd_decomp` lo convierte en `JDR_INTR` y la foto se da por fallida. Ver §6 |

Si el resolvedor de PlatformIO no encuentra los paquetes de `ESP32Async`, usar la forma con URL de git y tag:

```ini
    https://github.com/ESP32Async/ESPAsyncWebServer.git#v3.6.0
    https://github.com/ESP32Async/AsyncTCP.git
```

**Las seis versiones ya están pineadas** — las de arriba son las que resolvieron en el primer build limpio y las que están en el `platformio.ini` real. Eran siete: `claws/BH1750@1.3.0` salió el 8-ago-2026 al sustituir el sensor por un TSL2561, y **no entró ninguna en su lugar** — el driver vive en `firmware/src/luz.h`, y el porqué está en la sección del sensor. No usar `latest` en ninguna: cambia el comportamiento bajo los pies. Al actualizar cualquiera, actualizar también este bloque.

### La librería `SD` de Arduino NO se usa — 2026-08-07

**No monta las tarjetas de este proyecto.** Medido en placa desde
`firmware/banco/`, `[env:display]`, con **dos tarjetas distintas** (series de CID
`0x74161376` y `0x73F1513E`):

```
[W] ff_sd_initialize(): READ_OCR failed: 0
[E] sdcard_mount(): f_mount failed: (3) The physical drive cannot work
```

#### El mecanismo, medido y no deducido

`sd_diskio.cpp` manda **CMD59 (`CRC_ON_OFF`) con argumento 1 de forma
incondicional** (línea 542) y después exige un OCR con el bit 20 puesto de un
**CMD58 hecho todavía en estado idle** (línea 565). Rehaciendo la secuencia a
mano sobre los mismos pines, a 400 kHz, con el CRC7 calculado de verdad:

| CMD59 | OCR del primer CMD58, en idle | |
|---|---|---|
| ninguno | `0x40FF8000` | ✓ |
| argumento **0** — CRC OFF | `0x40FF8000` | ✓ ← **el control** |
| argumento **1** — CRC ON | `0x00000000` | ✗ ← lo que hace el driver |

**El control es lo que lo cierra.** Manda el mismo número de comandos que la ruta
que falla, así que la variable es el estado del CRC y no el tiempo ni un comando
de más. Dos observaciones que lo rematan:

- **Los cuatro ceros no son un OCR vacío.** En SPI una tarjeta ocupada mantiene
  `DO` en bajo, o sea que está contestando **«ocupada»** a ese CMD58 concreto.
- **El mismo CMD58 después de ACMD41 devuelve `0xC0FF8000` correcto**, con el CRC
  igual de encendido. No es que la tarjeta no sepa contestarlo: es esa ventana.

R1 vuelve `0x01` sin el bit de error de CRC, así que **no** es un CRC mal
calculado por el driver.

#### Por qué no se puede esquivar, y por qué no basta con cambiar de tarjeta

- CMD59 es incondicional y `supports_crc` arranca en `true` (línea 776): no hay
  hueco desde el código del proyecto.
- **El master de arduino-esp32 tiene el mismo código** — comprobado, no supuesto.
  No hay arreglo río arriba ni versión a la que subir.
- Las dos tarjetas son **distintas** por número de serie pero de la misma familia
  (fabricante `0x1B`, modelo `00000`). Un PNM en ceros es firma habitual de
  tarjeta clonada o re-etiquetada — **inferencia, no medición**. Una tarjeta de
  marca podría montar con el driver de siempre; no se probó y no hace falta.

#### Lo que se usa en su lugar: el driver sdspi de ESP-IDF

Vive en **`firmware/src/tarjeta.h`**, compartido por el marco y el banco igual
que `nombre.h`. **No es una dependencia nueva**: el IDF ya viene en la
plataforma. La clave es una línea:

```cpp
host.flags |= SDMMC_HOST_FLAG_SPI_IGNORE_DATA_CRC;   // salta el CMD59
```

El header del IDF lo dice literal: *«SPI mode only: Do not enable CRC
verification (skip CMD59)»* (`sd_protocol_types.h:213`). Ese paso es
**condicional** ahí, y en el de Arduino no.

**El montaje se envuelve en un `fs::FS` sobre `VFSImpl`**, que es exactamente lo
que hace la librería `SD` por dentro (`SD.cpp`: `SDFS SD = SDFS(FSImplPtr(new
VFSImpl()))`). Con eso `File`, `open()`, `exists()` y sobre todo el
`request->send(fs, "/manifest.txt", "text/plain")` de ESPAsyncWebServer —el
streaming sin heap de §3— **siguen siendo el mismo código**. Era el argumento que
descartaba a SdFat, que no es un `fs::FS` y habría obligado a reescribir el
streaming con respuesta por trozos.

**Coste medido:** `[env:marco]` pasa de 56,004 a **56,744 B de RAM** y de
1,232,933 a **1,274,699 B de flash** (+740 B y +41.8 KB). Es lo que pesa
`esp_vfs_fat` + sdspi frente al `sd_diskio` hecho a mano de Arduino.

> **Y el pipeline de visualización encima cuesta +64 B de RAM y +13.3 KB de
> flash** (56,808 y 1,288,031 B, 7-ago-2026). Los 64 B sorprenden hasta que se
> mira dónde está el workspace de `TJpg_Decoder`: el global `TJpgDec` son
> **3,580 B de `.bss`** que **el binario ya pagaba con cero llamadas** —
> comprobado recompilando `HEAD` y buscando el símbolo con `nm`, no supuesto. O
> sea que enlazar la librería es lo que cuesta la RAM, y usarla no cuesta nada
> más: el heap durante la decodificación se midió en **+0 B**. Detalle en §6.

**`format_if_mount_failed` se queda en `false` a propósito.** Formatear sola la
tarjeta ante un montaje fallido borraría las fotos, que es el único sitio donde
viven. Un fallo de montaje se reporta, no se «arregla».

#### Contacto intermitente del slot, 8-ago-2026 — y por qué parecían dos averías

Tras sacar la tarjeta para vaciarla desde la Mac y volver a meterla —la primera
manipulación en toda la sesión— el lector empezó a fallar de dos formas que
parecían no tener relación:

- **Tres arranques seguidos sin montar**, y luego dos montando bien.
- Con la tarjeta montada, **una escritura que se corta a la quinta foto**:
  `sdmmc_write_blocks failed (0x108)` y `(0x105)`, tras un `0x107` (`ESP_ERR_TIMEOUT`).

**El segundo síntoma deja el volumen inservible también para LEER**, y eso no es
obvio: FatFs se queda con el buffer de sector sucio e intenta volcarlo en cada
`open()` posterior, así que un camino de solo lectura empieza a escupir errores de
**escritura** cada 30 s, al ritmo de `FOTO_PERIODO_MS`. La consecuencia visible es
que `/list` contesta vacío y la galería dice «el marco todavía no tiene fotos»
sobre una tarjeta que sí las tiene.

**El diagnóstico que lo cerró fue sacar la tarjeta y mirarla en la Mac**, y vale la
pena como método porque separa tarjeta de lector en un paso:

| Comprobado en la Mac | Qué descarta |
|---|---|
| `diskutil verifyVolume` → `fsck_msdos` código 0 | corrupción del sistema de archivos |
| Las 4 fotos escritas, con sus bytes **exactos** y JPEG válidos | que las escrituras no llegaran |
| `manifest.txt` con sus 4 líneas correctas | que el anexado fallara |

O sea que la tarjeta estaba sana y el firmware había hecho su trabajo. **Lo que
falló fue el contacto del slot**, y reasentarla lo arregló: después aguantó una
tanda de 30 sin un solo fallo. Un chip muriéndose habría dejado corrupción.

Si vuelve: reasentar, mirar contactos y soldadura, y **bajar el reloj de 20 a 10
MHz** en `montarTarjeta()` como prueba discriminante — una conexión marginal
aguanta a 10 y falla a 20; una tarjeta muerta falla a las dos. Se pierde lectura
(1.21 → 0.78 MB/s) y poco más; las cuatro frecuencias están medidas más abajo.

**Y hay un detalle de `guardarFoto()` que confunde si no se sabe:** deja un JPEG de
0 bytes en `/fotos/`. El código **sí** limpia —hace `TARJETA.remove(ruta)` cuando
los bytes escritos no cuadran— pero con la tarjeta ya muda **hasta el `remove`
falla**. El archivo huérfano no es un bug del firmware, es el mismo fallo un paso
más allá.

#### La pega, y es real: dos dueños incompatibles del mismo bus

El `SPIClass` de Arduino arranca SPI2 con `spiStartBus` de `esp32-hal-spi`; el
driver del IDF lo arranca con `spi_bus_initialize`. **No pueden estar activos a
la vez.** El banco necesita los dos —las sondas de comandos crudos son de
Arduino— así que se turnan explícitamente con `tomarBusArduino()` y
`soltarBusArduino()`, y **las sondas desmontan la tarjeta**: después hay que
volver a montar con la tecla `M`. El marco solo usa el del IDF y no tiene reparto.

> **La trampa vieja del orden `hspi.begin()` antes de `SD.begin()` deja de
> aplicar al marco**, pero sigue valiendo para las sondas del banco y no se
> borra: `SDFS::begin()` llama a `spi.begin()` **sin argumentos** (`SD.cpp:34`), y
> `SPIClass::begin()` con todo por defecto sobre un HSPI sin inicializar asigna
> `sck=14, miso=12, mosi=13, ss=15` (`SPI.cpp:93-97`) — o sea que pone MISO en
> **GPIO12**, el pin de strapping prohibido, él solo, y la placa deja de bootear.

#### El banco compila con `CORE_DEBUG_LEVEL=3`

`[env:display]` lo lleva en `build_flags`. Por defecto PlatformIO compila en
nivel ERROR y toda la secuencia de init de la SD reporta sus fallos con `log_w`:
sin ese flag, un CMD8 o un ACMD41 que fallan se ven como un único `f_mount
failed: (3)` que no dice en qué paso fue. Fue lo que convirtió «no monta» en una
línea con número. **No va en `[env:marco]`.**

### El banco de red duplica tres de estas versiones a mano

`firmware/banco/` es un proyecto PlatformIO **aparte**, con su propio `platformio.ini`, su `src/` y su `.pio/`. Implementa el contrato HTTP de §4 sin SD y sin display, para desarrollar y medir la capa de red de la página contra el ESP32 real. No es la base del firmware final y no toca `[env:marco]`.

Repite copiadas a mano la plataforma pioarduino `55.03.311`, `ESPAsyncWebServer@3.12.0` y `AsyncTCP@3.5.0`. **Al actualizar cualquiera de las tres aquí, sincronizar allá.** Si divergen, el banco deja de probar lo que el firmware va a correr — que es el único motivo de que ese mock esté en el ESP32 y no en Python. El archivo del banco lleva el aviso en su encabezado, pero eso se lee estando ya dentro; el desfase se produce editando **este** lado.

#### `firmware/banco/` tiene cuatro envs, uno por cosa que se mide

| env | Qué prueba | GPIOs | `lib_deps` |
|---|---|---|---|
| `mock` | El contrato HTTP de §4, sin SD y sin display | ninguno | las dos async, duplicadas a mano |
| `led` | `LedRGB` contra el LED real | 25, 33, 4 | ninguna |
| `wifi` | El provisioning de WiFiManager — pendiente #5, **etapa 1** | 25, 33, 4 (el LED) | `WiFiManager`, duplicada a mano |
| `display` | El display y el sensor de luz — pendientes **#1, #3 y #4**. El #4 se reabrió al cambiar el BH1750 por el TSL2561; la tecla `L` saca además los lux con los que se calibra §7 | 18, 23, 5, 17, 16, 19 · 21, 22 | `TFT_eSPI`, duplicada a mano. El sensor NO lleva librería: `../src/luz.h` |

`default_envs = mock`, así que `pio run` a secas sigue compilando solo el banco de
red; los otros tres se piden con `-e led`, `-e wifi` y `-e display`. Cada uno lleva
su `build_src_filter` — sin eso los cuatro `setup()` acaban en el mismo binario.

#### Los flags de TFT_eSPI son la única excepción a la copia manual

`env:display` **no copia** los flags de TFT_eSPI: los toma de `../tft_comun.ini`
con `extra_configs`, el mismo archivo que usa `[env:marco]`. Es deliberado y es la
única duplicación de este proyecto que se resolvió compartiendo. La asimetría
tiene una razón concreta:

- Una **versión de librería** divergente es **detectable**: produce otro binario y
  el encabezado de cada `.ini` lo avisa. Se acepta copiarla.
- Un **pin de TFT** divergente no se nota por ningún lado: haría que el banco
  probara **otro circuito**, en silencio. Y todo el sentido del pendiente #3 es que
  su respuesta se transfiera al marco — con otros pines no se transfiere nada.

**Tampoco hay caída silenciosa si el archivo falta**, que es la propiedad que este
proyecto ya le exige a `WM_STRINGS_FILE`. Verificado renombrándolo a mano:

```
InvalidProjectConfError: Invalid '…/banco/platformio.ini': 'No section: 'tft''
```

**Y `../tft_comun.ini` resuelve bien desde cualquier directorio**, también con
`pio run -d firmware/banco` desde la raíz del repo — comprobado en la fuente de
PlatformIO instalada, no supuesto: `run/cli.py:108` hace `with fs.cd(project_dir)`
**antes** de construir el `ProjectConfig`, y `project/config.py:119-123` resuelve
el patrón con `glob.glob` ya dentro de ese directorio. Una sección `[tft]` tampoco
emite warning: la validación salta todo scope que no sea `platformio` ni `env`
(`project/config.py:131-133`).

**`SPI_FREQUENCY` y `SPI_READ_FREQUENCY` se quedan fuera del archivo compartido, a
propósito.** La primera es justo la variable del pendiente #3, y dejarla local es
lo que hace que el barrido de tres binarios del banco no toque nunca la
configuración del marco.

**`env:led` y `env:wifi` compilan `firmware/src/LedRGB.cpp` en su sitio, sin
copiarlo** (`+<../../src/LedRGB.cpp>` en los dos). El banco tiene que probar el
mismo archivo que va a correr en el marco. La advertencia de sincronización manual
de arriba **no le aplica a `env:led`** —no usa ninguna librería— pero **sí a
`env:wifi`**, que duplica `WiFiManager@2.0.17`.

> **Los dos objetos de `LedRGB.cpp` comparten ruta, y eso ya se midió.** El `..`
> del filtro deja el objeto en `.pio/build/src/LedRGB.cpp.o`, un nivel ARRIBA del
> directorio de cada env. Como SCons firma por contenido **y flags**, y los de los
> dos envs difieren, alternar entre `-e led` y `-e wifi` **recompila** ese archivo
> — verificado, sale `Compiling .pio/build/src/LedRGB.cpp.o` al cambiar. Es un
> recompilado de un segundo, no un objeto viejo colándose.

**`env:wifi` también trae el portal en español** (`-D WM_STRINGS_FILE`), porque
tiene que probar el portal que corre en el marco y no otro. Ver la sección del
pendiente #5.

Lo que responde, y que no se puede decidir desde el escritorio: el pinout medido
del LED, la corriente real por canal (ver la nota de las resistencias, arriba), si
a igual duty los tres canales dan el mismo brillo, y si un fade lineal en duty se
**ve** lineal o hace falta gamma. Lleva además una autocomprobación de la
interpolación que corre sin mirar el LED.

#### Cómo se apunta la página al banco

**La ruta preferente es LittleFS del propio ESP32** — `pio run -t uploadfs` desde `firmware/banco/`, que sirve `web/index.html` sin copiarlo. Ahí la página y el endpoint son el **mismo origen**, que es la configuración de producción: sin CORS, sin fragmento, y `CFG.BASE` con su valor por defecto.

Para iterar rápido con la página abierta desde la Mac hay un override, y **solo funciona bajo `CFG.DIAG`**:

```
file:///…/web/index.html#marco=http://192.168.100.175
```

Va en el **fragmento** a propósito: no viaja al servidor, y por lo tanto no puede colarse como una ruta que el `onNotFound` tendría que atender. Ese camino exige compilar el banco con `-D BANCO_CORS`, que es una cabecera de banco y **no puede sobrevivir al firmware final**.

### `SPI_FREQUENCY` — pendiente #3 CERRADO, 2026-08-07: **40 MHz**

Medido en placa con `[env:display]`, tres binarios, sobre jumpers de protoboard. `fillScreen` de 10 pantallas cronometradas, y la misma pantalla recorrida en bloques de 16×16 —600 `pushImage`— que es el camino real de `TJpg_Decoder`:

| Nominal | Real en el silicio | ms/pantalla | MB/s | % del techo | En bloques 16×16 | Sobrecarga | Imagen |
|---|---|---|---|---|---|---|---|
| 27 MHz | 26.67 (80/3) | 93.2 | 3.30 | 98.9 % | 108 ms · 1.16× | 14.8 ms | limpia |
| **40 MHz** | **40.0** | **62.3** | **4.93** | **98.6 %** | **77 ms · 1.24×** | **14.7 ms** | **limpia** |
| 80 MHz | 80.0 | 31.6 | 9.72 | 97.2 % | 45 ms · 1.42× | 13.4 ms | limpia |

**El SPI nunca fue el cuello.** El bus escala al 97-99 % de su techo teórico en las tres frecuencias, y `SPI_FREQUENCY=27000000` corre de verdad a **26.67 MHz** porque el reloj sale de dividir los 80 MHz del APB entre un entero — por eso el techo calculado del macro nominal queda ~1.3 % optimista solo en esa fila.

**Lo que no escala es la sobrecarga por transacción: 14.8 / 14.7 / 13.4 ms**, o sea ~23 µs por bloque de `setWindow` más ciclo de CS. Es CPU y protocolo, no bus, y por eso el factor sube de 1.16× a 1.42×: a 80 MHz ya es un tercio del camino de producción. Confirmado por una tercera vía, el patrón de rayas: 320 `drawFastVLine` cuestan 99 / 67 / 36 ms, con la misma sobrecarga fija encima del tiempo de bus.

**Los tres patrones salieron limpios en las tres frecuencias**, verificado de vista: rayas verticales de 1 px sin bandas ni cambios de fase, ocho barras planas en su orden correcto, y texto con rejilla y borde rojo de 1 px completo en los cuatro cantos. **Ni siquiera 80 MHz falló.**

**Entonces por qué 40 y no 80.** Porque la elección no es de velocidad: repintar una foto entera cuesta **77 ms a 40 MHz contra 45 a 80**, y en un marco que cambia de imagen cada varios segundos esa diferencia **no la percibe nadie**. Se toma el escalón que duplica el margen sobre los 27 MHz sin acercarse al límite del cableado. Pagar riesgo de integridad de señal por 32 ms invisibles es un mal negocio.

> **El resultado vale para el cableado con el que se midió** — jumpers de protoboard. El montaje final es UTP soldado y corto, que solo puede ir mejor. Si alguna vez se quiere reabrir esto, se repite el barrido con el cableado definitivo; el banco y los tres binarios siguen ahí.

**El panel NO necesita `TFT_INVERSION_ON`.** Era la sospecha más probable cuando el primer arranque salió raro, y quedó descartada por medición: la polaridad de fábrica de esta unidad es la correcta, y `tft.invertDisplay()` —la tecla `v` del banco— produce el complemento exacto de cada color, así que el control funciona y el valor por defecto es el bueno. TFT_eSPI no envía `INVON` ni `INVOFF` en el init del ST7796 salvo que se le declare el flag (`TFT_eSPI.cpp:774`), o sea que el panel se queda con su polaridad de fábrica.

> **Dos confusores que hay que quitar ANTES de barrer, o se anotan como límite del bus.**
>
> 1. **Desacoplo.** El backlight conmuta ~100 mA a 5 kHz por PWM, y un riel que se hunde produce **líneas y píxeles corridos** — exactamente el síntoma con el que se juzga «el SPI va demasiado rápido». El **100 nF cerámico pegado a los pines `VCC`/`GND` del display** va puesto desde la primera medición, no a mitad del barrido: es el que atiende los flancos, que es lo que importa aquí. El electrolítico de 100 µF **es el del lector SD** y no hace falta para un banco de solo display; se le puede prestar mientras la SD no esté conectada, pero es préstamo y no un capacitor adicional — en inventario hay uno solo.
> 2. **El cableado con el que se mide.** La frecuencia máxima estable depende del largo de los hilos y de si van trenzados con un retorno de tierra. Medir con jumpers largos sueltos y luego soldar UTP corto deja el resultado **pesimista**; al revés, optimista y con corrupción que aparece ya montado. Medir con hilos parecidos a los definitivos, o anotar con cuáles se midió.

### Nunca escribir a la SD desde el callback de upload

El callback de upload de `ESPAsyncWebServer` **no corre en `loop()`**: corre en el hilo `async_tcp`, a prioridad 10 y con 16384 B de stack. Y está en la única ruta por la que entran fotos al marco.

**Cuánto tarda una escritura, con los números medidos y no con la estimación vieja.** Esta sección decía «decenas de milisegundos», y la tabla de rendimiento de la tarjeta —130 líneas más abajo— la deroga: **crear un archivo nuevo cuesta 241 ms de media** a 20 MHz, y el **peor caso observado son 464 ms**, un borrado previo de bloque. Los 67 ms que también aparecen en aquella tabla son de *reescribir el mismo archivo*, que no paga asignar clusters ni actualizar el directorio y la FAT; no son los de subir una foto.

El patrón correcto, aprovechando que los archivos llegan a 32 KB en el peor caso:

- Acumular los chunks en un buffer de heap, **reservado al arrancar** (ver abajo).
- Escribir a la SD **una sola vez**, cuando `final == true`.
- **Tope duro de 64 KB.** Si se excede, responder `413` y dejar de acumular de inmediato. Sin ese tope, un cliente roto o malicioso tumba el heap del ESP32.

#### El buffer se reserva al ARRANCAR, y la medición lo dice sin ambigüedad

**`mayorBloque` durante una subida real, con AsyncTCP arriba y una conexión viva,
son 25,588 B.** El buffer necesita **65,536 contiguos**. O sea que un `malloc` por
subida **no fallaría por poco: fallaría por 2.5×**, y en la única ruta por la que
entran fotos al marco.

| Momento | heap libre | `mayorBloque` |
|---|---|---|
| Arranque | 265,904 | 110,580 |
| Tras reservar los 64 KB | 161,368 | **42,996** |
| Antes de `autoConnect()` | 110,496 | 42,996 |
| Después de `autoConnect()` | 109,336 | 42,996 |
| **Durante una subida, AsyncTCP arriba** | **~87,000** | **25,588** |

> **El suelo con el PORTAL CAUTIVO abierto ya está medido, 8-ago-2026, y era lo
> que faltaba para cerrar esta decisión.** En el recorrido de placa virgen, con la
> tarjeta montada y los cinco globales construidos: **`minHist = 64,560 B`**. Muy
> por encima de los ~40 KB por debajo de los cuales habría que mover el `malloc`
> detrás de `autoConnect()`, así que **la posición actual se queda** y no hay que
> tocar nada.
>
> Ojo con qué cifra se cita: `minHist` es `ESP.getMinFreeHeap()`, o sea el mínimo
> **acumulado desde el arranque**, y por eso la línea `[etapa2-postAutoConnect]`
> sirve aunque `medir()` no llegue a correr mientras el portal bloquea. El
> `mayorBloque` de esa misma línea **no** vale para esto: es el del instante
> posterior y no dice nada del portal. Para capturarlo haría falta una llamada
> desde `setAPCallback`, y con este margen no hace falta.

Por eso el `malloc` va en `setup()` y no se libera nunca. **La posición dentro de
`setup()` tampoco es libre**, y son dos restricciones que tiran en sentidos
opuestos:

- **Después del bloque del manifiesto**, porque `reconstruirManifiesto()` deriva su
  bloque de ordenación de `largest_free_block / 2`. Pedir los 64 KB antes bajaría
  `B` de ~13,822 a ~5,630 fotos sin ninguna necesidad.
- **Antes de `WiFiManager`**, por la tabla de arriba.

Dos cosas más que salen de esos números y conviene no perder:

- **La ruta de subida no fragmenta.** `mayorBloque` se quedó clavado en 25,588 B
  durante doce subidas seguidas, sin moverse un byte, y el heap libre osciló entre
  86,948 y 87,380. Es la misma propiedad que ya tenía el driver de SD.
- **Los 42,996 tras el `malloc` no son 110,580 − 65,536 = 45,044.** Los ~2 KB de
  diferencia son cabecera y alineación del asignador. Poco, pero explica por qué la
  resta a mano no cuadra al comprobarlo.

> **Escribir una sola vez reduce el NÚMERO de ventanas bloqueantes; no saca la escritura de `async_tcp`.** Es la consecuencia que faltaba escribir aquí y la que decide el diseño. Ese último callback y el handler de respuesta corren en el **mismo hilo de prioridad 10**, así que con 241 ms de media para crear el archivo más el append al manifiesto, el bloqueo por foto queda en el orden de los **300 ms**, no en «decenas». Una sola ventana de 300 ms en vez de varias, pero ventana al fin.

Si aun con una sola escritura truena el watchdog, la salida es cola de FreeRTOS + tarea dedicada de escritura y responder `202` en vez de `200`. Es más complejo y solo se paga si hace falta — **no empezar ahí: primero medir.** El criterio de disparo, para no dejarlo a ojo: se escala si durante una tanda real aparece `Task watchdog got triggered` o `Guru Meditation` en el monitor serie, si alguna foto falla con error de red reproducible atribuible al bloqueo, o si el p95 de tiempo por foto supera los 2 s. **Watchdog y conexiones caídas son dos fallos distintos y se anotan por separado.**

#### Medido, 2026-08-07: la escritura en línea aguanta, y no se escala

**43 subidas contra la placa desde la Mac, ninguno de los tres criterios se
disparó.** Ni un `Task watchdog got triggered`, ni una conexión caída, y el tiempo
de extremo a extremo por foto quedó en **0.20-1.45 s** con mediana ~0.4 s sobre
archivos de 32,828 B — el p95 ni se acerca a los 2 s. La cola de FreeRTOS y el
`202` **no hacen falta**, y esta sección se queda como está.

Los ~300 ms de bloqueo estimados están en el orden correcto, y contra un TWDT de
5 s sobre las tareas idle no había margen de que trocara. Lo que sí aparece es
**contención con `loop()`**, y sale como latencia y no como fallo: los picos de
1.4 s coinciden con una decodificación en curso.

> **El mecanismo de esa contención conviene tenerlo escrito, porque no es
> evidente y podría haber sido corrupción.** FatFs viene con
> `FF_FS_REENTRANT = 1` en esta plataforma, o sea que **toma un mutex por
> volumen**: la escritura de `async_tcp` y la lectura del JPEG que hace `loop()`
> se serializan en vez de pisarse. El precio es la espera, con
> `FF_FS_TIMEOUT = CONFIG_FATFS_TIMEOUT_MS = 10000 ms` de tope — o sea que en el
> peor caso una subida podría esperar 10 s por el volumen y devolver `FR_TIMEOUT`,
> que aquí sale como `507`. Nunca se observó por encima de 1.45 s, pero el techo
> existe y es 10× el timeout que la página **no** tiene: el suyo son 10 s también,
> así que en ese caso extremo los dos vencen a la vez.

Detalle de los endpoints y sus códigos de respuesta en §4 de la especificación funcional.

---

## Datos de referencia

### Display AR3952

| Parámetro | Valor |
|---|---|
| Controlador | ST7796S |
| Panel | TFT **IPS** |
| Resolución | 320×480 nativo (2:3) — **se monta vertical**, que es la orientación nativa del panel |
| Voltaje | 3.3 / 5 VDC |
| Área de pantalla | 74.5 × 50 mm |
| PCB | 94.8 × 59.19 mm |
| Peso | 41 g |
| Pines | 9, **sin soldar** |

> **Para el diseño de la carcasa:** montado vertical, el área activa mide **50 mm de ancho × 74.5 mm de alto**. El PCB sobresale ~20 mm respecto al área visible, y de forma asimétrica, sobre el eje vertical. Ahí es donde el bisel tiene que trabajar.
>
> **Medido sobre la carcasa v1 impresa, 9-oct-2026:** el vidrio queda a **5 mm** del borde del PCB **arriba y abajo**, y a **2 mm** a los lados. La tira de arriba lleva los **pines**; el borde negro del vidrio es más grueso **abajo** (su barbilla). O sea que la asimetría está en el vidrio, no en el PCB, y la v1 —que suponía todo el sobrante abajo— dejaba la ventana 4.6 mm alta. Corregido en la v2. Sigue sin medir el borde negro del vidrio arriba; se supone igual al lateral (~2.6 mm).

> **Relación de aspecto:** montado vertical, 320×480 es exactamente **2:3**. La lógica se invierte respecto del montaje horizontal que se contemplaba antes: ahora las **verticales de celular (3:4) casi llenan la pantalla** —salen en 320×427, con 11 % del alto en negro—, y son las **horizontales las que quedan a la mitad**: una 4:3 sale en 320×240, con 50 % del alto en negro. Una vertical 2:3 de réflex encaja con recorte cero; una horizontal 3:2 de réflex es ahora el peor caso, con 56 %. Justificación completa en §6 de la especificación funcional.

### Capacidad de la SD de 8 GB

~7.4 GiB utilizables tras formatear FAT32, o sea **7,945,689,498 B** — esa es la base de la tabla, que antes no estaba escrita y no cuadraba con los números.

| Peso por foto | Fotos que caben |
|---|---|
| 25 KB | ~310,000 |
| **32 KB** (el peor caso real, ver abajo) | **~242,000** |
| 40 KB | ~194,000 |
| 60 KB | ~129,000 |

> Esta tabla es **estimación de capacidad**, no un ajuste ofrecido a quien sube fotos. El peso lo decide el firmware de la página (presupuesto de 0.213 B/píxel, ver §4 de la especificación funcional); quien usa el marco nunca elige una calidad. Pedirle esa decisión violaría la regla 1.

### El cluster de 32 KB, que es donde está lo interesante

Una SDHC de 8 GB formateada según la especificación SD usa **clusters de 32 KB**, y el presupuesto de 32,768 B de §4 coincide **exactamente** con uno. No es una coincidencia aprovechada por accidente: una foto dentro de presupuesto ocupa un cluster y ni un byte más.

El borde importa. Una foto que **tope la cota de calidad** y salga en 33 KB consume **dos clusters, 64 KB — el doble**. Con 242,000 fotos de capacidad no es un problema de espacio, pero es la razón por la que el panel de diagnóstico de la página marca en ámbar las fotos por encima del presupuesto: no es decoración, marca el cruce de esa frontera.

Consecuencia para la tabla de arriba, que mide presupuesto y no ocupación real:

| Peso por foto | En disco | Fotos que caben de verdad |
|---|---|---|
| 25 KB | 32 KB (1 cluster) | ~242,000 |
| 32 KB | 32 KB (1 cluster) | ~242,000 |
| 40 KB | 64 KB (2 clusters) | ~121,000 |
| 60 KB | 64 KB (2 clusters) | ~121,000 |

Bajar del presupuesto no compra capacidad; pasarse la corta a la mitad.

**Y el caso medido cae del lado de los dos clusters.** El peso medio real de una tanda de 30 fotos de iPhone está entre **34 y 37 KB**, siempre por encima de los 32,768 B del presupuesto. Tres tandas medidas: **34.0**, **37.2** y **34.5 KB** (ésta última, 1,060,496 B en 30 fotos, es la primera que aterrizó en la tarjeta del marco; la mediana fue 34,158 B y **15 de las 30 pasaron del presupuesto**). No se cita un valor único a propósito: depende del contenido de la tanda, y tres muestras no fijan una constante.

O sea que la fila que describe la realidad de este proyecto no es la de 32 KB sino la de 40: **~121,000 fotos**, no 242,000. Sigue sin ser una restricción —son más fotos de las que nadie va a tomar— pero el orden de magnitud que hay que citar es ése. El piso de calidad `q = 0.620` es el régimen normal, no la excepción.

**El peor caso medido no ha dejado de subir, y por eso no se usa como cota.** Van 40.3 KB (tirol blanco), 43.0 (malla metálica perforada), 50.7 (un perro sobre césped) y **60.4 KB (61,836 B)**, el récord del 7-ago-2026 dentro de una tanda normal de 30 fotos de iPhone. Ese récord vale aunque la tanda fuera contra el banco y no contra el marco: **el JPEG lo produce entero el navegador**, y qué servidor lo recibe no cambia un byte. Otra tanda de 30 el mismo día, ésta sí contra el marco, topó en 51,898 B — o sea que el récord depende del contenido y no del recorrido. Todas son el mismo fenómeno: la búsqueda binaria toca el suelo de calidad y se acepta por encima del presupuesto, que es el comportamiento correcto de §4. Cualquier constante dimensionada contra el récord del día envejece en la siguiente tanda — este párrafo lleva cuatro revisiones al alza y es la prueba.

**8-ago-2026: el récord NO subió, y por primera vez se repitió al byte.** Una tanda de 30 contra el marco volvió a topar en **61,836 B exactos** — el mismo número del 7-ago. Misma foto y encoder determinista: mismo archivo. Sirve de control de que la página produce salidas reproducibles, no de que el récord se haya estabilizado.

**Lo que sí subió es la media, y era lo previsto:** mediana **41,484 B**, media **41,177 B** y **23 de 34 por encima del presupuesto**, contra los 34.5 KB y 15 de 30 de la tanda anterior al auto-llenado. Recortar sube el peso, y con el auto-llenado eso dejó de ser la excepción. El margen contra el tope duro sigue en **1.06×**, así que la advertencia de arriba no se relaja.

> Se intentó lo obvio —igualar el búfer de retención del banco al tope duro, para que no hubiera fotos sin verificar— y **se midió que no sale a cuenta**: `mayorBloque` cae de 34804 a 16372 B tras levantar el WiFi, la mitad del bloque contiguo mayor, con AsyncTCP pidiendo memoria por conexión. Ese búfer no lo limita el tamaño de las fotos sino el heap, y es un lujo del banco que el firmware real no va a tener. Se queda en 48 KB, y una foto mayor se reporta como «no retenida», que no es corrupción.

**Y el margen contra el tope duro se está cerrando, que es lo que hay que mirar.** 61,836 B contra los 65,536 del tope son **1.06×** — un 6 %. Era 1.26× con el récord en 50.7 KB y 1.6× con el de 40.3. Por encima de ese tope el servidor responde `413` y la página no tiene más salida que descartar la foto, así que **eso dejó de ser un riesgo teórico**: una sola foto con más textura que ésa, en la tanda de alguien, y la persona ve una foto que no se puede subir sin entender por qué.

Tres salidas cuando toque, en orden de menos a más invasiva, y **ninguna se construye hoy** porque el `413` sigue sin haberse dado en una tanda real:

1. **Subir el tope duro.** Es una constante en dos sitios (`TOPE_SUBIDA` del firmware y `TOPE_FIRMWARE` de la página) y el buffer ya se reserva al arrancar, así que el coste es heap fijo: 96 KB dejarían `mayorBloque` en ~11 KB al arrancar, que es poco margen para el resto. Medir antes de tocarlo.
2. **Bajar el piso de calidad** por debajo de `q = 0.620`. Es una línea en `web/index.html`, pero degrada **todas** las fotos que topan el suelo, no solo la que se pasa.
3. **Reintentar esa foto sola con un piso más bajo** cuando el servidor conteste `413`. Es lo correcto —solo castiga a la foto que lo necesita— y es también lo único de los tres que añade un camino de código nuevo a la capa de red.

**Verificar al preparar la tarjeta.** 32 KB es lo que trae de fábrica y lo que produce el SD Card Formatter oficial, pero macOS puede elegir otro tamaño al reformatear. Se confirma con `diskutil info /dev/diskNs1`, campo de tamaño de asignación.

La capacidad dejó de ser una restricción del proyecto.

### Verificado en hardware real, 2026-08-05

La tarjeta física ya se preparó y se midió, no solo se asumió de la ficha:

- **Cluster de 32,768 B confirmado.** Método usado, en Windows:

  ```powershell
  Get-CimInstance Win32_Volume -Filter "DriveLetter='F:'" |
    Select-Object DriveLetter, Label, FileSystem, BlockSize
  ```

  → `BlockSize 32768`. Coincide con lo asumido arriba. `diskutil info /dev/diskNs1` (macOS, campo Allocation Block Size) sigue siendo la alternativa válida si se reformatea desde Mac.
- **Label `MARCOFOTOS`.** Sin uso funcional en el firmware — es solo identificación de la tarjeta física frente a otras SD del inventario.
- **`/fotos/` y `.metadata_never_index` creados desde Windows**, antes de que la tarjeta tocara macOS. El segundo evita que Spotlight indexe el volumen y deje `.Spotlight-V100` en la raíz — ver la nota de la raíz, abajo.

  > **Corrección, 7-ago-2026: ese archivo NO evita `.fseventsd`.** La tarjeta preparada lo tiene en la raíz, y no tiene `.Spotlight-V100`: son dos mecanismos distintos y `.metadata_never_index` solo apaga el indexado. No cambia ninguna decisión —las fotos no van en la raíz precisamente por esto— pero la afirmación estaba de más.
  >
  > **Y macOS deja además un `._NNNNNNNN.JPG` por cada foto DENTRO de `/fotos/`.** Son sidecars AppleDouble de 4 KB, ocultos a un `ls` normal, y aparecen al copiar desde la Mac — que es como se cargan las fotos mientras `/upload` no exista. **No hay que filtrarlos a mano**: `nombreValido()` los rechaza por longitud (15 ≠ 12), y el recorrido de reconstrucción los cuenta como descartados. Medido en placa: `7 validas, 7 descartadas`. El guard contra `?n=../manifest.txt` resultó cubrir también la basura real del sistema de archivos.
- **Alineación de partición — ASUMIDA, no verificada.** La partición se reformateó con Disk Management. Si en vez de reformatear se hubiera recreado la partición, quedaría alineada a 1 MB y no al erase block de la tarjeta. Irrelevante para esta carga de trabajo (fotos de hasta 64 KB, sin escritura aleatoria de alto volumen), pero no se afirma en ningún sentido porque no se midió.

**Dos límites reales que sí importan:**

1. **No poner las fotos en la raíz.** No es por un límite de entradas: el famoso tope de 512 entradas en el directorio raíz es de **FAT16**, no de FAT32 — en FAT32 la raíz es una cadena de clusters ordinaria y crece igual que cualquier subdirectorio. Las razones reales son otras: macOS deja metadatos en la raíz del volumen (`.Spotlight-V100`, `.fseventsd`, `.Trashes`) que el firmware tendría que filtrar en cada recorrido, y conviene separar las fotos de `/manifest.txt` y de cualquier otro archivo de servicio. Las fotos van en `/fotos/`.
2. **Archivo manifiesto.** Recorrer el directorio en cada cambio de foto se vuelve lento con miles de archivos. Mantener un índice que el ESP32 lee al arrancar y actualiza solo al subir o borrar. Formato y fallback en §3 de la especificación funcional.

### Rendimiento de la tarjeta — medido en placa, 2026-08-07

Todo con archivos de **32,768 B**, que es el peso de una foto que llena la
pantalla y además un cluster exacto. Desde `[env:display]`, tecla `w`, 10
muestras por frecuencia. El **cluster de 32,768 B quedó confirmado desde el
ESP32** midiéndolo por consumo —un archivo de 1 byte y el delta de espacio
usado—, y coincide con lo que dio Windows.

| Reloj | Escritura min / mediana / **máx** | Lectura | MB/s de lectura |
|---|---|---|---|
| 4 MHz (el default de la librería) | 116 / 130 / 131 ms | 83 ms | 0.39 |
| 10 MHz | 69 / 83 / **464** ms | 42 ms | 0.78 |
| **20 MHz** | **55 / 67 / 67 ms** | **27 ms** | **1.21** |
| 25 MHz (tope de la especificación) | 51 / 64 / **265** ms | 24 ms | 1.37 |

**La lectura escala con el reloj; la escritura satura en ~0.5 MB/s.** De 4 a 25
MHz son 6.25× de reloj y solo 2× de escritura: el cuello es el tiempo de
programación interno de la tarjeta, no el bus. Por eso **se elige 20 MHz** — da
el 88 % de la lectura de 25 dejando margen bajo el tope de la especificación, que
es el mismo criterio con el que se eligieron los 40 MHz del display.

#### Dos números que no se ven en esa tabla y que importan más

**Crear un archivo nuevo cuesta 241 ms de media, no 67.** Medido creando 100
archivos seguidos a 20 MHz: 24,137 ms en total. La tabla de arriba reescribe
**el mismo** archivo, así que no paga asignar clusters ni actualizar el
directorio y la FAT. El número de la subida de una foto es el de 241 ms.

**El peor caso es medio segundo, no «decenas de milisegundos».** Los 464 ms de la
fila de 10 MHz son un borrado previo de bloque, y aparecen de forma esporádica:
salieron a 10 y a 25 MHz pero no a 20, en corridas de 10 muestras. Con tan pocas
muestras la cola está submuestreada y **no se debe tomar 464 ms como cota**, del
mismo modo que el peor caso de peso de JPEG de §4 no se usa como cota.

> **Consecuencia para el timeout por foto de §4, que estaba puesto a ojo:** los
> `TIMEOUT_MS: 10000` de `web/index.html` quedan **confirmados con margen**. El
> peor caso observado —464 ms de escritura más los 315 ms/foto ya medidos del
> iPhone contra el banco— son ~800 ms, o sea **12× de margen**. No hay que
> cambiar el valor, pero ahora tiene base medida en vez de una estimación.

#### Recorrer el directorio: 4,763 µs por entrada

100 archivos recorridos con `openNextFile()` en **476.3 ms**. Es el número que
decide la viabilidad del fallback de reconstrucción del manifiesto de §3, y
extrapolado a las 121,000 fotos de capacidad da **9.6 minutos**. Detalle y
consecuencias en §3 de la especificación funcional.

`openNextFile()` **abre** cada archivo, no solo lee su entrada de directorio, y
ahí está buena parte del coste. Si algún día ese número estorba, la salida es
`readdir()` sobre el VFS, que no abre nada — no se hace hoy porque el recorrido
solo ocurre cuando el manifiesto falta.

**Contrastado con fotos reales desde `[env:marco]`, 7-ago-2026:** el fallback ya
está implementado y su recorrido dio **4,500 y 6,214 µs/entrada** en dos
corridas, sobre 14 entradas —7 fotos de 8 a 65 KB más los 7 sidecars de macOS—.
Los 4,763 µs de arriba caen dentro, así que la extrapolación de §3 se sostiene,
pero **con 14 entradas la medición es ruidosa: las dos corridas difieren un 38 %
entre sí, y no se debe citar un valor único.** La cifra buena para extrapolar
sigue siendo la de los 100 archivos.

### Sensor de luz — TSL2561 (sustituye al BH1750 el 8-ago-2026)

| Parámetro | Valor |
|---|---|
| Módulo | Handson Technology, SKU `SSR1026` — $127 |
| Chip | TSL2561, dos canales: Ch0 visible+infrarrojo, Ch1 solo infrarrojo |
| Interfaz | I2C, hasta 400 kHz |
| Dirección | **`0x39` — medido 8-ago-2026**, con el pad al aire. (`0x29` con `L`, `0x49` con `H`) |
| Rango | 0.1 – 40,000 lux (del módulo); techo real según ganancia e integración |
| Alimentación | **`Vin` a 5 V** — el módulo lleva LDO `662K` de 3.3 V |
| Consumo | 0.6 mA máximo |
| Driver | **`firmware/src/luz.h`, propio. Sin librería** — abajo está por qué |

**Por qué se sustituyó y no se repuso.** El GY-302 se estropeó en el banco el
7-ago-2026 (diagnóstico completo más abajo, y merece la pena por la técnica). En
vez de comprar otro BH1750 se subió de gama: el TSL2561 tiene **dos fotodiodos**
y una fórmula que resta el infrarrojo, y eso importa aquí más de lo que parece —
un fotodiodo solo mide **4× más counts por lux** bajo luz incandescente que bajo
fluorescente, o sea que «100 lux» significaría cosas distintas según la lámpara
de la sala. Con los dos canales esa dependencia se colapsa a ~1.0.

#### Configuración elegida: ganancia 16×, integración 101 ms

No es el valor por defecto y la combinación **no es libre**. Los tres tiempos que
ofrece el chip dan techos muy distintos, y el techo importa porque **saturar hace
que la fórmula devuelva casi cero** — o sea que el sol por la ventana apagaría la
pantalla:

| Integración | Fondo de escala | Techo con fluorescente | Techo con incandescente |
|---|---|---|---|
| 402 ms | 65,535 counts | ~1,820 lux | **~455 lux** ← descartada |
| **101 ms** | **37,177** | **~4,100 lux** | **~1,020 lux** |

**Medido con luz de día el 9-ago-2026: el techo real son ~1,740 lux**, que es donde cae el espectro del sol tras un vidrio (cociente Ch1/Ch0 = 0.42, entre el fluorescente y el incandescente de la tabla). **Y se alcanza a diario:** el cuarto simplemente iluminado por el sol satura `ch0` en las 10 muestras de 10, sin apuntar a nada. Saturar no es un caso extremo con esta configuración — es el modo normal de operación de día, y la rama de saturación del firmware es lo que lo convierte en «brillante» en vez de en un lux sin sentido.
| 13.7 ms | 5,047 | ~4,120 lux | ~1,030 lux |

402 ms queda fuera por eso, no por lenta: 455 lux es una sala normal junto a una
ventana. 13.7 ms tiene el mismo techo que 101 ms pero **7.4× menos resolución**.
Con 101 ms quedan 91 counts a 10 lux —el umbral bajo de §7— contra un offset de
oscuridad de 0-4 counts.

**Aun así se satura junto a una ventana, y el firmware tiene una rama para eso**
que trata «saturado» como «brillante». Es la respuesta correcta y es también lo
que hace innecesaria la autoganancia de las librerías: por encima del techo ya no
hay nada que decidir.

**La cadencia de sondeo no cambió.** `LUZ_PERIODO_MS` sigue en 200 ms: el peor
caso de la integración, con `fosc` en su mínimo de 690 kHz, son 108 ms, o sea
1.85× de margen. La rampa de §7 se queda en ~41 s y no hubo que rejustificarla.

#### La dirección: tres candidatas, y el PDF del módulo se contradice

`ADDR SEL` es un pin de **tres estados por diseño** (datasheet, Tabla 1), y en
este módulo **no sale al header**: lo fija un puente de tres pads soldables
marcados `H | centro | L`.

| Pad | ADDR | Dirección |
|---|---|---|
| **al aire** (como viene) | flotante | **`0x39`** |
| centro con `L` | GND | `0x29` |
| centro con `H` | VDD | `0x49` |

**MEDIDO el 8-ago-2026: `0x39`**, con la tecla `i` de `[env:display]`. Y es el
**único** dispositivo del bus, o sea que el pad viene al aire de fábrica.

Hubo que medirlo porque las dos mitades del PDF del módulo se contradicen: su
texto y sus tres fotos dicen `0x39`, pero su **esquemático dibuja otra cosa** —un
interruptor de dos estados con pull-down de 4.7 kΩ, que daría `0x29`—. Ganaron el
texto y las fotos, que era la apuesta: **ese esquemático ya había fallado en otro
punto verificable**, diciendo 4.7 kΩ donde la foto de la placa muestra
resistencias marcadas «103», o sea 10 kΩ.

Si algún día un módulo de recambio no contesta con el bus sano, la salida es
**puentear el pad central con `L`**: eso ata `ADDR` a GND y fija `0x29` de forma
determinista, sin depender de un pin flotante.

#### Las líneas I2C están a 3.3 V con `Vin` a 5 V — MEDIDO 8-ago-2026

**`SDA` y `SCL` dieron 3.2 V las dos**, con el módulo alimentado y fuera del bus.
O sea que **las pull-ups cuelgan del riel post-LDO y no de `Vin`**, y el módulo se
conecta a GPIO21 y GPIO22 directo, sin nivelador.

Los 3.2 V no son «bajos»: el chip pide `VDD` entre 2.7 y 3.6 V y el ESP32 da por
alto cualquier cosa por encima de ~2.48 V, así que la diferencia contra el 3.3
nominal del LDO cabe entera en la tolerancia del instrumento. Cuadra además con
lo que este mismo proyecto midió en el bus del GY-302 cuando estaba sano: 3.14 y
3.18 V en reposo.

**Que las dos lean lo mismo dice algo de más:** las dos resistencias están
puestas y van al mismo riel. Una sola discrepante habría sido pull-up ausente o
colgada de otro sitio.

> **Por qué esta medida no se saltó, aunque la teoría ya la daba por buena.** El
> esquemático dice que R1 y R2 van al post-LDO, y el propio chip lo respalda: su
> máximo absoluto en las líneas digitales es **3.8 V**, con `VIH` máximo de 3.6,
> así que un módulo con las pull-ups en 5 V destruiría su propio chip. Pero es el
> mismo esquemático que ya falló en dos puntos verificables, y lo que estaba en
> juego eran GPIO21 y GPIO22. **Fue el tercer punto donde podía fallar y no
> falló** — que es exactamente lo que hace que la medida valiera los treinta
> segundos: el resultado esperado no es el resultado sabido.
>
> La prueba solo discrimina **con `Vin` a 5 V**. Repetida a 3.3 V no dice nada,
> porque entonces las dos topologías posibles dan la misma lectura.

#### El módulo se averió el 10-ago-2026 y SE REPARÓ: le falta el condensador de 10 µF

**Estado físico actual: el módulo NO está de fábrica, y hay que saberlo antes de
compararlo con su esquemático.** El cerámico de 10 µF de la salida del LDO (C2)
se agrietó y quedó en cortocircuito; se quitó y **se sustituyó por un
electrolítico de 10 µF / 63 V de through-hole**, soldado así:

| Pata | Va a |
|---|---|
| **Positivo** | uno de los dos pads que dejó libre el cerámico — el que da 3.3 V contra GND |
| **Negativo** (franja) | el pin **`GND` del header** |

**El negativo al header es deliberado, no pereza.** Es la misma red —en el módulo
la tierra es un plano continuo— y a cambio el condensador queda anclado a un
taladro pasante con pad grande en vez de a un pad SMD de 0805, que es mucho más
robusto para una lata que va a vivir dentro de una carcasa. El lazo se alarga unos
nanohenrios y aquí da igual: **el trabajo de lazo corto lo siguen haciendo los dos
cerámicos de 0.1 µF que no se tocaron**, y lo que le faltaba al riel era capacidad
de grueso a baja frecuencia. Bulk lejos, cerámica cerca.

Que sea electrolítico tampoco es un problema: los LDO que se desestabilizan son
los que exigen ESR **mínimo**, y el ESR de un electrolítico más bien añade un cero
que ayuda al margen de fase.

**Lleva silicón caliente**: de pie sobre dos alambres, la lata es una palanca.

El cuadro, por si vuelve a pasar con otro módulo:

| Síntoma | Medida |
|---|---|
| El `662K` **hirviendo**, el componente más caliente del montaje | — |
| Consumo por `Vin` | **0.23-0.24 A**, o sea 400× los 0.6 mA de especificación |
| `Vin` contra GND | 4.0 V — los 230 mA hundían el riel de 5 V del devkit |
| Riel de 3.3 V contra GND | **0.1 V** |
| Resistencia riel↔GND | **<1 Ω** |

Los 230 mA son el **límite de corriente** del XC6206 empujando contra el corto, y
la tensión del riel es ese límite por la resistencia del corto. Cuando las tres
medidas cuadran entre sí, el diagnóstico está cerrado.

> **La trampa del diagnóstico, y cuesta una tarde: EN CIRCUITO, los componentes
> en paralelo son indistinguibles.** Los tres condensadores del riel, el `VDD`
> del chip y la salida del regulador cuelgan de los mismos dos nodos, así que con
> el riel en corto **todos** marcan continuidad con GND en sus dos terminales. Eso
> no significa «están todos malos»: significa «el riel está en corto», que ya se
> sabía. La única salida es quitarlos de uno en uno midiendo después de cada uno.
> La alternativa de laboratorio —inyectar corriente constante y seguir la caída de
> microvoltios por el cobre— necesita fuente de banco y un multímetro que no es el
> de mano.

**El diagnóstico también respondía a la causa raíz, y por eso valía la pena
aunque el módulo acabara en la basura.** Si el corto hubiera persistido tras
quitar los tres condensadores, estaría dentro del chip o del regulador — la misma
firma que mató al BH1750, y la sospecha de un problema sistémico. **Salió un
pasivo agrietado**, o sea mecánica o azar. Las dos averías tienen mecanismos
**distintos** y no hay patrón que perseguir.

**Verificado tras la reparación:** riel a 3.3 V, `Vin` de vuelta a 4.7 V,
**regulador Y lata del electrolítico a temperatura ambiente** —lo segundo es lo
que confirma la polaridad, porque un electrolítico invertido con 3.3 V encima se
calienta antes de fallar—, `0x39` respondiendo, y la tecla `L` dando
**135.7 lux con 0 % de dispersión** —ocho de diez muestras idénticas al count—
dentro del rango de 126-137 medido antes de la avería y con el mismo cociente
Ch1/Ch0. Sin el condensador daba 132.4 con 1 %; la mejora hasta el 0 % es
probablemente escena más quieta y no el condensador, así que lo que se afirma es
que **el electrolítico no introdujo degradación**, no que sea mejor.

> Ojo con lo que esa última prueba demuestra: el sensor **integra 101 ms**, así que
> promedia cualquier oscilación del LDO hasta hacerla invisible. El 1 % dice que
> el riel sirve para esta aplicación, **no** que el regulador sea estable. La
> evidencia contra la oscilación es que el `662K` se quedó a temperatura ambiente.

#### El encapsulado decide los coeficientes, y no se puede leer del chip

El datasheet trae **dos juegos** de coeficientes: uno para el encapsulado CS y
otro para T, FN y CL. La numeración de pines del esquemático del módulo
(1=VDD, 2=ADDR, 3=GND, 4=SCL, 5=INT, 6=SDA) **descarta CL** pero no CS.

**El registro ID no sirve para esto**, contra lo que uno esperaría: solo
distingue TSL2560 de TSL2561, no el encapsulado. La foto del módulo muestra patas
periféricas con menisco de soldadura, lo que apunta a T — inferencia sobre un
JPEG, no medición.

`luz.h` usa el juego **T/FN/CL**, y **la duda se cierra el 8-ago-2026 sin
resolverla**, que no es lo mismo que ignorarla:

- **Que el módulo funcione NO prueba el encapsulado.** Funcionaría igual con el
  juego equivocado, solo con el lux sesgado. Ese no es el argumento.
- El argumento es que el sesgo es **menor que el error que ya se acepta**: ≤30 %
  con luz incandescente y ~4 % con fluorescente, contra el **±35-40 % de
  tolerancia de fábrica del propio chip** (datasheet, Nota 8).
- Y en **esta** instalación es aún menor: el cociente Ch1/Ch0 medido es 0.146
  —iluminación LED—, y en ese punto los dos juegos difieren **~5 %**.
- Calibrar los umbrales de §7 contra la sala real absorbe los dos, y es lo que
  hay que hacer de todas formas — tecla `L` del banco.

Si alguna vez hiciera falta de verdad, se decide **con calibrador** y no con
software: **T mide 3.80 × 2.60 mm** y **CS mide 1.75 × 1.25 mm**, o sea el doble,
y no se confunden.

#### Por qué no hay librería de sensor

Se evaluaron las tres candidatas y se descartaron, y **el motivo es estrecho**:
de lo que una librería de TSL2561 aporta, lo único no trivial es la
**autoganancia**, y este marco no la usa. §7 colapsa la salida del chip a tres
bandas, y con 16× y 101 ms la saturación cae **casi seis veces por encima** del umbral
superior — donde la rama de saturación y la autoganancia dan la misma respuesta.
El resto de la librería son cuatro llamadas a `Wire`.

| Candidata | Coste |
|---|---|
| `adafruit/Adafruit TSL2561` | Arrastra Unified Sensor: mete 2 para sacar 1, y el set pineado subiría de 7 a 8 |
| `sparkfun/SparkFun TSL2561` | Sin dependencias, pero sin tocar desde 2015 — el mismo argumento con el que se descartó Croppr.js |
| `joba-1/Joba_Tsl2561` | Trae la autoganancia, que es lo único con valor real, pero es de un solo mantenedor en la pieza que gobierna el backlight |

En su lugar, `firmware/src/luz.h`: ~40 líneas sobre `Wire`, compartido con el
banco igual que `nombre.h` y `tarjeta.h`. **El set pineado baja de siete a seis.**
Sigue el precedente que este proyecto ya sentó dos veces — `strstr` en `/delete`
en vez de ArduinoJson, y el recuadro propio en vez de Cropper.js.

**La condición que invalidaría la decisión, escrita por adelantado:** si el marco
alguna vez tiene que reportar lux **de verdad** —a la pantalla, a un log, a la
página— la librería vuelve a la mesa. Con tres bandas, no.

> **Y esto cuesta flash, al revés de lo que se esperaba.** Quitar `BH1750` y
> meter `luz.h` dejó el binario en **RAM 56,832 B y flash 1,339,447 B**, o sea
> **−24 B de RAM pero +2,432 B de flash** contra la referencia del 8-ago
> (56,856 y 1,337,015). El culpable está identificado con `nm`: **`powf` y su
> `__ieee754_powf` son 1,910 B** que antes no se enlazaban, porque ninguna otra
> parte del firmware elevaba a una potencia fraccionaria. El primer tramo de la
> fórmula de lux lleva un `(Ch1/Ch0)^1.4`.
>
> Se acepta. Son 1.9 KB sobre una partición de 3 MB —el 0.06 %— y el ESP32 tiene
> FPU, así que el coste en tiempo es despreciable. El datasheet ofrece una
> aproximación lineal por tramos precisamente para librarse del `pow`, pero la
> escribió para micros de 8 bits sin coma flotante; aquí solo cambiaría exactitud
> por nada.

#### Autocomprobación: la fórmula se verifica sin sensor

`luzLuxOk()` corre en cada arranque, en el marco y en el banco, y usa la **tabla
de responsividad del propio datasheet**: a 402 ms y 16×, una fuente fluorescente
da Ch0 = 36 counts/lux y Ch1 = 4, y una incandescente da 144 y 72. Escalados a
101 ms y a 100 lux salen `(907, 101)` y `(3629, 1814)`, y **las dos tienen que
devolver ~100 lux pese a diferir 4× en counts** — que es exactamente el trabajo
que hace la fórmula.

Verificado en el host contra el archivo real: **99.26 y 99.77 lux**. Atrapa un
coeficiente mal tecleado, un borde de tramo cambiado, la normalización olvidada y
los dos canales intercambiados.

Comprueba además la **histéresis** (`luzBanda()`), y no que clasifique —eso es
trivial— sino que **retenga**: 90 lux tiene que leerse como «brillante» viniendo
de brillante y como «tenue» viniendo de tenue. Es el mismo motivo por el que
`LedRGB::lerp` está extraída: una histéresis mal puesta no se ve mirando la
pantalla, solo cronometrándola.

#### Lo que se conserva del BH1750 porque no depende del chip

> **Un voltímetro NO detecta `SDA` y `SCL` intercambiados, y esto costó un rato.** Con los dos cables cambiados el bus se ve perfecto: `VCC` a 3.2 V y las dos líneas en reposo a 3.14 y 3.18 V, porque las pull-ups del módulo están ahí igual en cualquier orden. El escaneo simplemente no encuentra nada y las tres medidas obvias salen bien.
>
> Por eso `escanearI2C()` del banco **escanea en los dos órdenes**: primero el del BOM y, si sale vacío, con `SDA` y `SCL` cambiados. Si aparece en el segundo, lo dice y avisa de corregir **los cables, no el firmware** — el mapa del BOM es el que va a acabar soldado, y `main.cpp` tiene `Wire.begin(21, 22)`. Fue exactamente lo que pasó al conectar el GY-302 la primera vez.
>
> **Lo que SÍ cambió es el consejo de cuando no contesta nadie.** Con el BH1750 el sospechoso era `ADDR` flotando a media escala, porque ese chip exige <0.3×VCC o >0.7×VCC y en medio no responde. **En el TSL2561 flotante es un estado legítimo** —es `0x39`— así que ya no es la avería: la sugerencia pasa a ser puentear el pad con `L` para fijar `0x29` sin depender de un pin al aire.

#### El GY-302 se estropeó en el banco, 2026-08-07 — historia, y una técnica que se queda

Después de dar su medición y responder en `0x23` dos veces, el GY-302 dejó de aparecer en el bus y **no volvió**. Causa **indeterminada**: no se sabe si llegó tocado, si se dañó durante la sesión, o qué lo dañó. Se llegó a sospechar del barrido a 80 MHz y **esa hipótesis se retiró** — ninguna medida la sostiene, y el escaneo I2C no se capturó en la corrida de 40 MHz previa, así que ni siquiera está acotado el momento en que dejó de funcionar.

**La avería está dentro del módulo**, y esto sí es concluyente:

| Se comprobó | Qué descarta |
|---|---|
| El síntoma no cambia al moverlo a otras filas del protoboard | el protoboard |
| Header soldado y pines en su posición | el montaje |
| `VCC` a **3.25 V** en el pin del propio módulo | la alimentación que le llega |
| Con el módulo fuera, las dos líneas leen alto | GPIO21/22, los jumpers y las filas |
| Con el módulo dentro, `SCL` y `SDA` clavados en **0.72 V** y **1.04 V** | — |

**Esa última fila es la firma, y es la técnica que vale la pena guardar: una línea clavada en ~0.7 V NO es un nivel lógico bajo, es una caída de diodo.** Si el chip aterrizara la línea de verdad, con la pull-up interna de 45 kΩ del ESP32 se leerían casi 0 V. Los 0.72 V son una unión de silicio conduciendo ~56 µA: la pull-up está metiendo corriente por el **diodo de protección** del pin hacia el riel interno del chip. Y un diodo de protección solo conduce en ese sentido cuando **ese riel está por debajo del pin**. O sea que el pin `VCC` del módulo tiene 3.25 V pero el `VDD` del BH1750 no los tiene: la rotura está entre uno y otro —regulador de a bordo, pista, o el chip— y no en nada externo.

> Antes de tirarlo: si el módulo lleva un **SOT-23 de tres patas** (regulador tipo 662K o XC6206), medir su salida contra GND. Entrada con 3.25 V y salida sin ellos = regulador muerto y chip sano. Las dos con 3.25 V = es el chip.

**No bloqueó nada, y ahí está lo interesante.** §7 ya exigía que sin sensor el marco se quede a brillo fijo y nunca en negro; `main.cpp` lo implementaba, y **esta avería ejercitó esa rama en hardware sin que nadie la provocara a propósito**. El marco siguió pintando fotos durante toda la sesión.

**Lo que sí se perdió fue la medición.** `0x23` valía para el BH1750, y al sustituirlo por un TSL2561 esa constante no se transfiere: el chip nuevo tiene otras tres direcciones. El pendiente #4 se reabrió por eso — no porque la medida de entonces estuviera mal.

---

## Pendientes de confirmar (requieren hardware en mano)

| # | Pendiente | Cómo se resuelve |
|---|---|---|
| 1 | ~~Tipo de pin `BL` (Caso A o B)~~ | **CERRADO 6-ago-2026. Caso B**, entrada lógica: 1.40 mA a 5 V y 0.88 mA a 3.3 V sobre 100 Ω. GPIO19 directo, sin transistor. Arriba |
| 2 | ~~Pinout emisor/colector del PN2222A~~ | **CERRADO por irrelevancia**, mismo día: el Caso B saca al transistor del diseño. Arriba |
| 3 | ~~Velocidad SPI máxima estable~~ | **CERRADO 7-ago-2026: 40 MHz.** Las tres dieron imagen limpia; se elige por margen, no por velocidad. Tabla completa arriba |
| 4 | ~~Dirección I2C del sensor de luz~~ | **REABIERTO y VUELTO A CERRAR el 8-ago-2026**, al cambiar el BH1750 por el TSL2561: el `0x23` era correcto pero de otro chip. **`0x39` medido**, único dispositivo del bus, pad al aire. Mismo método que la vez anterior — tecla `i` de `[env:display]` |
| 5 | ~~WiFiManager con arduino-esp32 ≥3.1.0~~ | **CERRADO 6-ago-2026.** No panica. Ver abajo |

**Los cinco vuelven a estar cerrados**, tras la reapertura del #4 por el cambio de sensor. Ninguno forzó un cambio de plataforma ni de circuito, y dos —el transistor del backlight y el pinout del PN2222A— desaparecieron del diseño en vez de resolverse.

**Pero el #4 volvió a abrirse el 8-ago-2026, y no por un error de la medición.** El BH1750 se estropeó en el banco después de dar su `0x23`, y en vez de reponerlo se sustituyó por un **TSL2561**. Ese chip tiene otras tres direcciones posibles (`0x29` / `0x39` / `0x49`), así que la constante medida no se transfiere y hay que volver a escanear. Detalle en la sección del sensor.

**Las dos comprobaciones visuales del #1 también están hechas, 8-ago-2026:** el brillo del display al 100 % con `BL` a 3.3 V es **el mismo** que a 5 V, y con `BL` desconectado el backlight queda en **0**, sin destello mientras GPIO19 flota. La primera confirma que el driver del módulo satura con los 0.88 mA que da un GPIO; la segunda convierte en observación directa lo que hasta ahora era inferencia de dos medidas de corriente.

### Pendiente #5 — CERRADO, 2026-08-06. El panic no ocurre

[Issue #1797 de tzapu/WiFiManager](https://github.com/tzapu/WiFiManager/issues/1797) reportaba que con arduino-esp32 ≥3.1.0 el portal provoca `Guru Meditation Error: Core 1 panic'ed`. **Verificado en placa que no ocurre en esta combinación**, con el provisioning completo de extremo a extremo:

borrar credenciales → arrancar virgen → AP `Marco-Fotos` → portal cautivo → elegir red y guardar → conecta → **reiniciar y reconectar solo, sin levantar el AP**.

Versiones exactas probadas: `WiFiManager@2.0.17`, plataforma pioarduino `55.03.311` (arduino-esp32 3.3.11 / IDF 5.5.5), `ESP32-D0WD-V3 rev v3.1`, 4 MB de flash. Los tres planes B (`#master`, bajar a `espressif32` 6.x, portal a mano sobre `ESPAsyncWebServer` + `DNSServer`) quedan sin usar.

#### La prueba se partió en dos etapas, y por qué

Para no confundir «es la librería» con «es la presión de heap» —el confusor #1— cada etapa mide con el mismo `printf`:

| Etapa | Qué corre | Dónde |
|---|---|---|
| 1 | WiFiManager + `LedRGB`, nada más | `firmware/banco/`, `[env:wifi]` |
| 2 | La vecindad real de `setup()`: los cinco globales, con `tft.begin()`, `SD.begin()` y `lux.begin()` ya corridos | `firmware/`, `[env:marco]` — el firmware de verdad, no una copia |

Heap libre en bytes, placa con credenciales guardadas en las dos:

| Punto de medida | Etapa 1 | Etapa 2 | Δ |
|---|---|---|---|
| Arranque (solo el LED) | 282,184 | 268,540 | −13,644 |
| Justo antes de `autoConnect()` | 230,988 | 214,760 | −16,228 |
| Justo después | 229,848 | 213,608 | −16,240 |

**Confusor #1 descartado con números.** Los cuatro globales de más cuestan 13,644 B de `.bss`, y sus `begin()` solo 2,584 B encima. Con el portal realmente abierto (etapa 1, placa virgen, 9 redes escaneadas) el mínimo histórico tocó **189,108 B libres** — o sea que el portal cuesta unos 42 KB de suelo transitorio sobre un margen de más de 200 KB.

**Y `mayorBloque` se quedó en 110,580 B en las seis mediciones de las dos etapas**, sin moverse un byte. No hay fragmentación. Contrasta con el banco de red, donde el mismo indicador cae de 34,804 a 16,372 B tras levantar WiFi porque AsyncTCP pide memoria por conexión — aquí no hay nada de eso.

##### Las cifras de la etapa 2 caducaron con el driver de SD — remedidas 7-ago-2026

La tabla de arriba se tomó con la librería `SD` de Arduino. El driver `sdspi` del
IDF que la sustituyó pide bastante más heap, así que **para comparar contra el
firmware de hoy hay que usar estos números**:

| Punto de medida | Etapa 2 con `SD.h` | Etapa 2 con `sdspi` | Δ |
|---|---|---|---|
| Arranque (solo el LED) | 268,540 | **265,972** | −2,568 |
| Justo antes de `autoConnect()` | 214,760 | **179,936** | **−34,824** |
| Justo después | 213,608 | **178,776** | −34,832 |

**El salto entero está entre las dos primeras filas, y tiene que ser así**: en la
del arranque la tarjeta todavía no se ha montado —solo se paga el `.bss` de más—
y los ~35 KB son lo que `esp_vfs_fat` + sdspi reservan al montar. La caída de
2,568 B de la primera fila es `.bss`, no heap de trabajo.

**`mayorBloque` sigue clavado en 110,580 B**, en las tres medidas y con el
pipeline de fotos corriendo encima. El driver nuevo cuesta heap pero **no
fragmenta**, que es lo que importaba: el margen sobre los 42 KB que el portal
necesita sigue siendo de más de 130 KB.

> **Un matiz que no se midió:** la etapa 2 corrió con credenciales ya guardadas, así que **no ejerció el portal**, solo la reconexión. Que el portal aguante bajo la presión de heap de la etapa 2 se infiere de restar los 42 KB medidos en la etapa 1 (quedarían ~172 KB), no está medido. Se cierra igualmente porque el margen es de un orden de magnitud; para medirlo habría que borrar credenciales con `env:wifi` (tecla `z`), flashear `env:marco` sin borrar la NVS y volver a provisionar desde el celular.
>
> Los otros dos confusores siguen como estaban: el **orden de inicialización** no aplica (`server.begin()` corre después de que `autoConnect()` retorna), y `asentarLed()` es landmark de bisección, no sospechoso (`delay()` es `vTaskDelay`).

#### Lo que sí salió roto: `getWiFiIsSaved()` miente antes de arrancar el driver

No es el panic, y para este proyecto es peor, porque golpea la regla 1 y **solo en el arranque que importa**.

Sobre una placa sin credenciales, `wm.getWiFiIsSaved()` devuelve **«sí»**. Medido con el código de retorno, no deducido:

```
ANTES de WiFi.mode(STA): esp_wifi_get_config=ESP_ERR_WIFI_NOT_INIT           → guardadas=sí
TRAS  WiFi.mode(STA):    esp_wifi_get_config=ESP_OK  ssid=""                 → guardadas=no
```

El mecanismo: `getWiFiIsSaved()` → `WiFi_hasAutoConnect()` → `WiFi_SSID(true)` → `esp_wifi_get_config(WIFI_IF_STA,&conf)`. Esa última devuelve `ESP_ERR_WIFI_NOT_INIT` y **no toca `conf`** si el driver no ha arrancado; WiFiManager ignora el código de retorno y construye el `String` con pila sin inicializar.

**La corrección es una línea: `WiFi.mode(WIFI_STA)` antes de preguntar**, ya puesta en `main.cpp` y en el banco.

- **No sirve fiarse de que `autoConnect()` acierta.** Acierta por otro camino: tiene su propia llamada a `getWiFiIsSaved()` **comentada** y un `wifiIsSaved = true` a pelo (`WiFiManager.cpp` 2.0.17, línea 283). El síntoma en el log era esa contradicción — nuestro «sí» seguido de su `No wifi saved, skipping`.
- **Por qué habría pasado todas las pruebas de banco:** con credenciales guardadas las dos lecturas coinciden en «sí». El fallo **solo existe en el primer arranque de una placa virgen**, que es exactamente el único arranque en el que alguien provisiona el regalo. Sin la corrección se pinta la pantalla de «conectando» en vez del QR de setup, y quien recibe el marco se queda sin nada que escanear.

#### El portal se tradujo al español, y el archivo `es` de la librería NO sirvió

`wm_strings_es.h` **viene en la librería pero no está traducido**: contenido idéntico al inglés salvo mayúsculas (`"Credentials Saved"` contra `"Credentials saved"`), encabezado «SAMPLE SAMPLE SAMPLE», versión 0.0.0. Comprobado cadena por cadena, no supuesto. **Activarlo no cambia nada — no volver a intentarlo.**

Las cadenas propias viven en **`firmware/src/wm_strings_marco.h`** y se enchufan con un build flag, que es el patrón que este proyecto ya exige para TFT_eSPI — **nunca editar la librería**, porque se pierde al actualizar y al clonar:

```ini
build_flags = -D WM_STRINGS_FILE='"wm_strings_marco.h"' -I src
```

`WiFiManager.h` hace `#include WM_STRINGS_FILE` (línea 141) con `wm_strings_en.h` por defecto. Va en los dos `.ini` —el del marco y el del banco, allá con `-I../src`— y el archivo propio incluye `wm_consts_en.h`, que trae rutas y tokens y **se queda en inglés a propósito**: son URLs, no texto visible.

**Como el `#include` es obligatorio, no existe la caída silenciosa al inglés:** si el archivo no se encuentra, el build falla. Y al actualizar WiFiManager, un símbolo nuevo rompe la compilación con «undeclared identifier» en vez de dejar un texto en inglés sin que nadie se entere.

**Verificado en el binario, no solo compilado:** `strings firmware.elf` encuentra `Conectar a tu WiFi`, `Guardar` y `Buscar otra vez`, y **no** encuentra `Configure WiFi`, `Show Password`, `Saving Credentials` ni `Available pages`. El inglés del portal no se enlaza.

##### El portal es de una sola página, y las que se quitan no son pérdida

`wm.setMenu({"wifi"})`. Eso baja la traducción de 101 símbolos a unos 15 —la mayoría del archivo es HTML, CSS y JS, que no se toca— y de paso responde a si convenía conservar la funcionalidad extra de la librería:

| Página | Por qué se quita |
|---|---|
| `update` | **No puede funcionar.** `huge_app.csv` tiene una sola partición de app (`app0`, sin `ota_1`), así que `Update.begin()` falla. Botón muerto por construcción |
| `erase` | Redundante y destructiva. Si cambian el módem, `autoConnect()` falla al arrancar y el portal vuelve a salir solo, más el toque largo de §8. Un botón que borra la configuración dentro de un regalo solo puede restar |
| `info` | ~40 filas de diagnóstico (chip id, heap, IDF, MAC): justo lo que la regla 3 prohíbe. Lo único útil de ahí —la IP— ya lo da el QR de uso diario con la IP en texto debajo |
| `restart` / `exit` / `close` | Tras guardar, WiFiManager cierra el portal por su cuenta |

Consecuencia: `/info` y `/update` **se quedan en inglés a propósito**, porque no hay enlace que lleve ahí. Y hay cadenas que **nunca** se traducen porque son protocolo y no texto: `S_debugPrefix` (el prefijo `*wm:` con el que se buscan los mensajes en el monitor serie), `S_GET`/`S_POST`, `S_options` y `S_parampre`.

Coste en flash: **−444 B**. Traducir no costó nada y vaciar `HTTP_HELP` —una tabla con la lista de rutas del portal, en inglés— devolvió más de lo que ocuparon los acentos.
