Mang0-TEC/esp32-photo-frame/carcasa/marco_tapa_trasera.stl

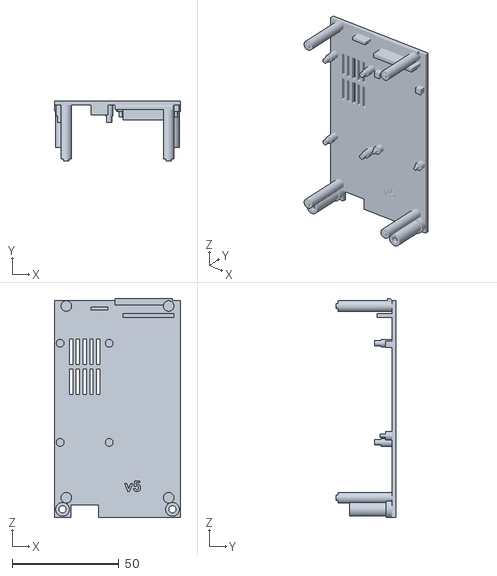
[picture p1: CAD file, 2026-10-13]
carcasa/marco_tapa_trasera.stl
59.3 x 28.4 x 102.8
