Mang0-TEC/esp32-photo-frame/carcasa/marco_carcasa_frontal.stl

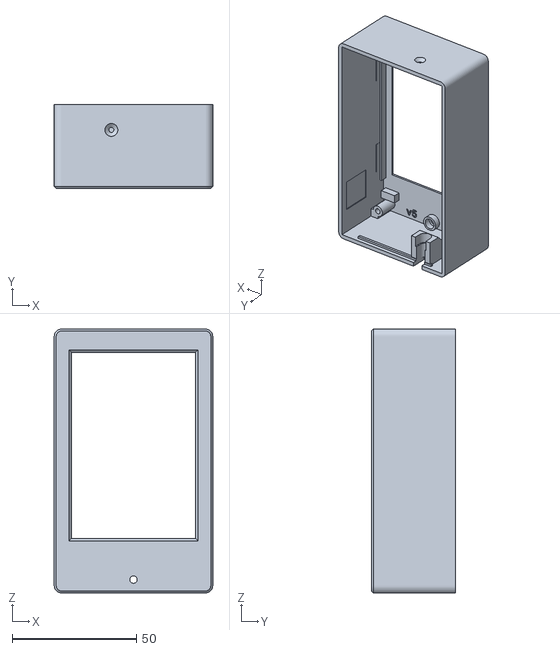
[picture p2: CAD file, 2026-10-13]
carcasa/marco_carcasa_frontal.stl
63.8 x 33.8 x 106.2
