Mang0-TEC/esp32-photo-frame/carcasa/marco_probeta_ajustes.stl

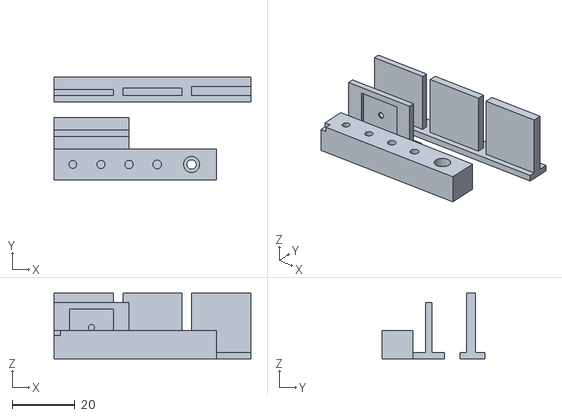
[picture p3: CAD file, 2026-10-12]
carcasa/marco_probeta_ajustes.stl
63.0 x 33.0 x 21.0
