Mang0-TEC/esp32-photo-frame/carcasa/marco_base_cuna.stl

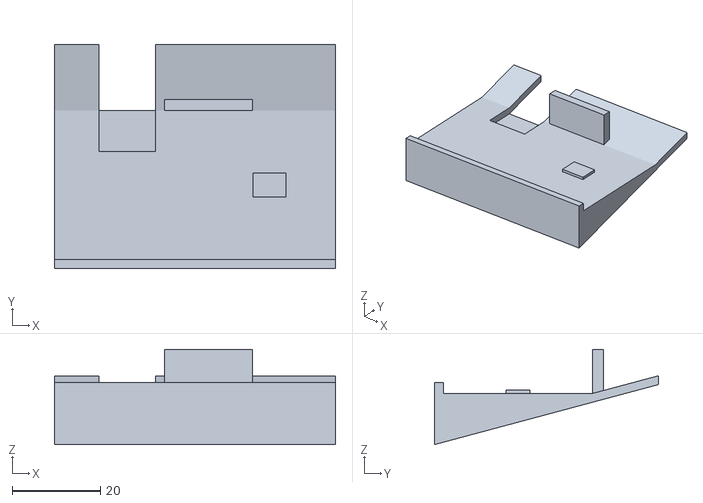
[picture p4: CAD file, 2026-10-11]
carcasa/marco_base_cuna.stl
63.8 x 50.8 x 21.6
