Mang0-TEC/esp32-photo-frame/(commit log)

2026-08-02 Documentos de diseño, toolchain y build verificado
2026-08-02 Fijar plataforma 55.03.311 y versiones exactas de librerías
2026-08-02 Corregir contradicciones y cerrar los huecos de diseño de la carga de fotos
2026-08-02 Fijar orientación vertical 320×480 y presupuesto por densidad
    El marco se monta vertical: una foto 3:4 de celular pasa de 240×320 a
    320×427, +78 % de imagen útil, y 320×480 es la rotación nativa del
    ST7796S. El costo simétrico —las horizontales a media pantalla— sube el
    recorte manual de mejora opcional a compensación necesaria.
    La decisión es irreversible: el navegador guarda las fotos ya ajustadas y
    el ESP32 no reescala, así que girar el marco obligaría a resubir todo. Se
    retira la promesa de rotación física de la carcasa.
    El presupuesto de bytes sube a 0.213 B/píxel de salida — 32,768 B al
    llenar la pantalla, exactamente un cluster de la SD. Sigue siendo una
    densida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
2026-08-02 Rejilla con multi-selección y cola de preparación
    §4 se contradecía a sí misma desde que el marco pasó a vertical: el paso 2
    del flujo decía que cada foto «se recorta automáticamente al centro» y el
    paso 4, dos líneas abajo, que se reduce «respetando proporción». Gana el
    paso 4 — es lo que hace el código, lo que supone §6 y lo único compatible
    con que exista un aviso de barras. El default es la foto completa con
    barras negras; el recorte es opt-in por foto. Un recorte automático
    decapita gente en silencio, y perder pantalla se deshace con un toque
    mientras que una cabeza cortada no se descubre hasta que el marco ya está
    en la sala.
    La página deja de procesar solo files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
2026-08-03 Editor de recuadro de recorte y «quitar foto»
    El recorte manual dejó de ser opcional cuando §6 fijó el marco en vertical: una
    4:3 horizontal sin recortar sale en 320×240 con la mitad del alto en negro, y
    recortada a 2:3 llena los 320×480. Esta es esa compensación.
    `escalar()` llevaba `(sx, sy, sw, sh)` en la firma desde la etapa 2 sin que nadie
    la usara. Ahora la consume: el recorte se aplica sobre el archivo ORIGINAL y el
    halving va de esa región al destino, así que recortar y deshacer las veces que
    haga falta no acumula pérdida. Lo autoriza que el `File` del selector de iOS
    sobreviva, que ya está medido — 30 fotos, teléfono bloqueado 10 minutos.
    Decisiones que costaron:
    -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
2026-08-03 Banco de red: sketch mock del contrato HTTP sobre ESP32 real
    Proyecto PlatformIO aparte en firmware/banco/, con la plataforma y las dos
    dependencias del servidor copiadas de [env:marco], que queda intacto.
    Implementa las cinco rutas de §4 sin SD y sin display, para desarrollar y
    medir la capa de red de la etapa 5 antes de que llegue el hardware.
    Un mock en Python confirmaría el protocolo, que es la parte que menos duda
    tiene. Lo que puede fallar vive en ESPAsyncWebServer: el upload multipart es
    donde estaban los bugs de concurrencia que motivaron usar el fork ESP32Async.
    Lo que salió de leer la librería, no de su documentación:
    - El callback de upload no recibe `total` y contentLengt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
    [banco.cpp]
2026-08-03 Capa de red: subida contra /upload con concurrencia 1
    Cierra la última pieza de la página. Los estados SUBIENDO, SUBIDA y FALLO
    existían en ESTADO sin producirse ni consumirse, y nombreRemoto era un campo
    vacío desde la etapa 3; ahora los escribe un bucle propio.
    Bucle aparte y no dentro de correrCola(). §4 no obliga a solapar preparación
    y subida —pide preparación secuencial y concurrencia de subida 1— y la tanda
    de 30 se prepara entera en 2711 ms medidos. Solapar compra esos dos segundos
    y paga con dos cancelaciones simultáneas, dos significados para el mismo
    botón, y la carrera de que el bucle agarre un item que el reproceso del
    recorte está a punto de reemplazar.
    La exclu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
2026-08-04 Capa de red: correcciones salidas de medir contra el ESP32
    Once pruebas contra firmware/banco/ en un DevKit WROOM real, desde Safari de
    iOS en un iPhone 11. Tanda de 30 en 9444 ms, 315 ms por foto, 107.9 KB/s, e
    integridad byte a byte en todas menos una, que el banco no retiene por tamaño.
    Lo que la medición encontró y aquí se arregla:
    - El resumen de diagnóstico se escondía en cuanto no quedaba nada en LISTA, o
    sea justo al terminar la tanda, que es cuando se lee. Ahora sobrevive, lleva
    los números de subida, y NOMBRA las fotos que no verificaron: un «29/30» sin
    decir cuál obliga a abrir treinta detalles.
    - La rejilla no invitaba a tocar una foto fallida. El recuento iba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
    [banco.cpp]
2026-08-04 LED RGB: tabla de estados, fade lineal, y banco para medirlo
    Revisión del módulo escrito en la sesión anterior, más el env que lo va a
    verificar contra el LED real. NADA DE ESTO ESTÁ PROBADO EN PLACA todavía: lo
    único medido son los tres builds, la interpolación comprobada en el host, y el
    arnés de la página en 84/84 para dejar constancia de que la tanda no rompió el
    otro lado. El circuito ya está soldado; la sesión de multímetro es la siguiente.
    Dos defectos contradecían §9 y la regla 3:
    - El verde de «conectado» no llegaba a verse. setup() ponía WIFI_OK y doce
    líneas después lo pisaba con IDLE_SHOWING; entre los dos solo había
    setupWebServer() y server.begin(),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
2026-08-06 Cerrar deuda entre el código y los documentos"
    CFG.DIAG pasa de true a false en web/index.html: es el valor que la propia
    especificación exige y que el comentario del código ya declaraba ("false para
    producción"), pero el archivo commiteado tenía el opuesto. Verificado antes de
    tocarlo: de las 15 apariciones de DIAG, las 14 que no son la definición ya
    estaban gateadas, y diagCard/diagFiles llevan hidden en el HTML estático — cero
    rastro suelto con el cambio. El arnés tenía una dependencia oculta del default
    viejo (dos casos asumían DIAG=true sin fijarlo ellos mismos); se corrige
    fijando CFG.DIAG = true al principio de casos.js, ya que el arnés prueba el
    comportamiento bajo diagn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
2026-08-06 LED RGB: medido en placa — el rojo a 220 Ω y el ámbar a (255,70,0)
    Sesión de banco sobre el LED ya soldado. El commit anterior decía que nada estaba
    probado en placa; esto es lo que salió de probarlo, y una predicción mía queda
    desmentida.
    El rojo pasa de 1 kΩ a 220 Ω, y el cálculo lo predecía al revés:
    Sobre el papel el rojo con 1 kΩ llevaba el doble de corriente que el verde y el
    azul con 470 Ω, y de ahí se predijo que el blanco saldría rosa. En placa pasa lo
    contrario: encendiendo un canal a la vez, el rojo se ve claramente más apagado y
    verde y azul salen intensos. El cálculo daba CORRIENTE y lo que decide es BRILLO
    PERCIBIDO — la curva fotópica pesa el verde ~4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
2026-08-06 WiFiManager: pendiente #5 cerrado, y el fallo real era getWiFiIsSaved()
    Provisioning probado de extremo a extremo en placa, en dos etapas para no
    confundir «es la librería» con «es la presión de heap»: env:wifi nuevo en
    firmware/banco/ con WiFiManager y el LED a solas, y [env:marco] tal cual con los
    cinco globales ya construidos. La etapa 2 no es una copia del entorno de setup():
    es el firmware de verdad, que ya lo era, más cuatro líneas de medición.
    El panic del issue #1797 NO ocurre:
    WiFiManager@2.0.17 sobre pioarduino 55.03.311 (arduino-esp32 3.3.11 / IDF 5.5.5),
    ESP32-D0WD-V3 rev v3.1. Virgen -> AP Marco-Fotos -> portal -> guardar -> conecta
    -> reinicio y reconecta solo, sin l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
    [LedRGB.h, led.cpp, main.cpp, wifi.cpp, wm_strings_marco.h]
2026-08-07 Backlight: BL es entrada lógica y el PN2222A sale — más el banco del display
    Cierra los pendientes #1 y #2 y deja montado lo que falta para el #3 y el #4.
    BL, medido con 100 Ω en serie: 1.40 mA a 5 V y 0.88 mA a 3.3 V, que ajustan
    3.17 kΩ de impedancia de entrada, mientras el panel enciende brillante. Esa
    corriente es unas 70 veces menor que la del backlight, así que la potencia sale
    de VIN por un driver del propio módulo y BL solo lo gobierna. Un cátodo crudo,
    además, no podría encender con 5 V aplicados al pin. Caso B, sin ambigüedad:
    BL va directo a GPIO19, PWM por LEDC, alto = brillante, SIN transistor.
    Con eso el PN2222A sale del diseño junto con sus 470 Ω de base y e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
2026-08-07 Display y sensor en placa: cierra los pendientes #1 a #4
    Cuatro pendientes de hardware resueltos, y dos de ellos desaparecen del diseño
    en vez de resolverse. Queda montado firmware/banco/ env:display, que es lo que
    los midió.
    #1 BL — es ENTRADA LÓGICA, no cátodo crudo. Medido con 100 Ω en serie: 1.40 mA
    a 5 V y 0.88 mA a 3.3 V, que ajustan 3.17 kΩ de impedancia de entrada mientras
    el panel enciende brillante. Esa corriente es ~70x menor que la del backlight,
    así que la potencia sale de VIN por un driver del módulo y BL solo lo gobierna.
    Un cátodo crudo tampoco podría encender con 5 V aplicados al pin.
    Co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
    [display.cpp]
2026-08-07 Lector SD en placa: coexiste con el display, pero la librería SD de Arduino no
    Los dos buses separados quedan verificados bajo carga sostenida, que era el
    riesgo real (issue #3601 de TFT_eSPI) y no que SD.begin() devolviera true. Por el
    camino salió que la librería SD de Arduino no monta estas tarjetas, y hubo que
    cambiarla.
    COEXISTENCIA — dos corridas de ~190 s, tarea de FreeRTOS en el core 0 escribiendo
    y releyendo 32 KB contra la tarjeta mientras loop() pintaba en el core 1.
    Concurrente y no alternado a propósito: es lo que hace producción, porque la
    escritura ocurre en el callback de /upload (async_tcp, prioridad 10) mientras
    loop() puede estar empujando píxeles.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
    [banco.cpp, display.cpp, main.cpp, nombre.h, tarjeta.h]
2026-08-07 El marco muestra fotos: manifiesto, TJpg_Decoder y barras en firmware
    Cierra el camino tarjeta -> decodificador -> panel. Antes TJpg_Decoder estaba
    enlazado con CERO llamadas y showNextPhoto() estaba vacío; ahora el marco lee el
    manifiesto, decodifica por bloques MCU de 16x16, calcula las barras negras y
    cambia de foto cada 30 s.
    CUÁNTO TARDA UNA FOTO, y el término que faltaba era el grande. Medido en placa
    sobre siete proporciones, con el empuje cronometrado dentro del propio callback:
    entrada salida esc getFsJpgSize dibujo empuje TOTAL
    320x480 320x480 1 17 ms 230 ms 80.7 ms 247 ms
    320x427 320x427 1 17 213 71.7 230
    2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
2026-08-07 El marco recibe fotos por sí solo: /upload, la página en flash y los dos QR
    Cierra el camino por el que entran fotos sin una Mac de por medio. Las tres
    piezas eran la misma historia: sin página no hay dónde subir, sin /upload no
    hay a dónde, y sin QR nadie llega a ninguna de las dos.
    /upload con el contrato entero de §4, verificado en placa con 43 subidas:
    200 con su nombre, 400, 413, y 503 con dos multipart a la vez. Contador de
    NVS monótono, manifiesto anexado, integridad byte a byte comprobada.
    El buffer de 64 KB se reserva al arrancar, y el número lo exige: mayorBloque
    durante una subida real con AsyncTCP arriba son 25,588 B. Pedirlos por subida
    habría fallado por 2.5×, en la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
2026-08-08 Confirmado: b8ba5b1 ya llevaba /upload, la página y los QR. Lo pendiente es todo lo de después.
    Mensaje de commit
    La galería cierra el contrato, y de paso descubre que la galería tira el marco
    POST /delete era la última ruta que la página no llamaba. Con ella llega la
    galería de lo ya cargado: ver todas las fotos de la tarjeta y quitar las que
    sobren, que es el objetivo de §4 — curación, no espacio.
    Sin endpoints ni dependencias nuevas: /list y /photo bastaban, y el cuerpo JSON
    se lee con strstr/strchr como en el banco, ocho líneas y cero heap. ArduinoJson
    se evaluó y se descartó por una clave de formato fijo en 30 B. El borrado va con
    la foto primero y el índice después,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
2026-08-08 El marco se configura solo: el puerto 80 que el portal cautivo no soltaba
    Primer recorrido completo de placa virgen, con los dos QR vistos en pantalla
    por primera vez. De ahí salió un fallo que solo existe en el arranque que
    provisiona: server.begin() da `bind error: -8` (ERR_USE de LWIP) porque el
    WebServer del portal todavía retiene el puerto 80. Con el bind caído el
    servidor no escucha nunca, así que el QR de uso diario apuntaba a una página
    que no cargaba — y como paginaAbierta la pone el handler de `/`, el QR
    tampoco podía retirarse. En un arranque normal no ocurre jamás.
    Se corrige reiniciando tras provisionar, con bandera en NVS que recuerde
    pintar el QR después; el dispar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
    [main.cpp]
2026-08-09 El brillo se ajusta solo: TSL2561 en vez del BH1750, sin librería y con histéresis
    El GY-302 se estropeó en el banco tras dar su 0x23, y en vez de reponerlo se
    sustituyó por un módulo TSL2561 ($127). No es un cambio pin a pin: lleva LDO
    propio (662K) y sube al riel de 5 V, ADDR deja de ser un cable y pasa a ser un
    puente soldable, aparece un INT que no se conecta, y el chip entrega dos canales
    crudos en vez de un registro de lux. Con eso la tabla A del BOM queda vacía por
    primera vez: $514 gastados, $0 pendientes.
    Sin librería, y el motivo es estrecho: de lo que aportan las tres candidatas lo
    único no trivial es la autoganancia, y §7 colapsa el sensor a tres bandas con la
    saturaci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
2026-08-09 Umbral alto de 100 a 300, medido el 9-ago-2026 y no elegido: el cuarto de día SATURA el sensor (≥1,740 lux) contra los 126-137 de noche con focos LED, o sea 13x de separación, y con 100 las dos caían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
    Dos correcciones a lo escrito ayer. Saturar NO es una esquina: es el modo normal
    de operación de día, 10 muestras de 10 con el cuarto simplemente soleado. Y el
    desplome de la fórmula que justificaba la rama de saturación NO se reprodujo —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
2026-10-11 La carcasa existe: prototipo v3 en PETG, sin soporte, ajustado a los CAD reales
    Modelo paramétrico en Fusion («Marco Ensamble», proyecto Marco Fotos): carcasa
    frontal, tapa trasera y base cuna a 15°, más una probeta de ajustes. ~150
    parámetros con su origen en el comentario (MEDIDO / CONFIRMADO / CAD / PENDIENTE
    / PROPUESTO / CALC), así que ajustar tras cada impresión es cambiar valores, no
    rehacer geometría. STL y 3MF en carcasa/, con README de impresión, montaje,
    pruebas y pendientes.
    Tres vueltas en un día, y cada una corrigió una suposición:
    - v1 suponía el sobrante del PCB del display abajo. La probeta y la carcasa
    impresa enseñaron que el vidrio está a 5 mm arriba y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
2026-10-11 El marco responde al toque: base que persigue, AP de recuperación y pantalla que despierta
    toque.h (nuevo, compartido con el banco): la base persigue el reposo a un paso
    por lectura en vez de calibrarse al arrancar —un dedo puesto durante el arranque
    la dejaba mal para siempre—, debounce de 3 lecturas, salida para el pad pegado
    (60 s) y toqueOk() corriendo al arrancar sin hardware.
    main.cpp: el toque largo sin WiFi levanta Marco-Fotos en AP_STA con sus dos
    relojes de 5 min (§5) y el QR cambia a la dirección del marco al asociarse
    alguien. Un toque con el backlight en 0 lo sube al 100 %; la rampa de §7 lo
    vuelve a apagar sola, sin estado nuevo.
    banco: tecla t en [env:display] mide r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
2026-10-12 Carcasa v4: lo que enseñó el test fit de la v3, y el USB-C ya no se puede arrancar
    Test fit en seco de la v3 impresa en PETG. El display entra con todo y PCB y el
    bisel tapa su borde; lo demás salió de medir y de revisar el modelo.
    Cambios por observación del test fit:
    - Ventana 0.5 mm más abajo: el bisel inferior cubría de más (medido con
    calibrador, < 1 mm).
    - Los dos postes inferiores del display no estaban en sus barrenos (5 mm de
    inset contra 5.58 / 2.42 reales). Ahora los cuatro llevan perno.
    - Tornillos M3x25 Allen (cabeza Ø5.5 x 3, medidos). El barreno era para M3x8 y no
    entraban. Cabeza al ras en un cajeado de la tapa, guía tubular hasta un poste
    corto que rosca s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
2026-10-13 Carcasa v5: holgura al USB-C, touch a la pared derecha y el TSL2561 girado
    Test fit de la v4 con el display, el ESP32 en la tapa y el cable conectado. La
    ventana baja, las rejillas, las marcas de versión, los M3x25, el LED y los dos
    tornillos inferiores quedaron bien y no se tocan.
    - Calza del USB-C con holgura: el cuerpo del conector chocaba con ella.
    - El aire sube de 0.5 a 2.5 mm (usb_calza_aire) y la calza baja de 14.5 a 12.5.
    - Las ranuras ya no aprietan: 0.5 mm por lado (usb_calza_holgura, nuevo).
    Queda Ø5.0 para el cable (antes 3.8) y 6.3 para la bota (antes 5.8).
    - La ranura del fondo sigue la misma regla y pasa de 4.5 a 5.0 mm.
    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
